horatioPistachio/WashingLineMonitor-P0001/Exports/WashingLineMonitor-P0001_AC/WashingLineMonitor-P0001_AC_BOM.csv

Reference | Qty | Value | Footprint | Supplier | Supplier Part Number | DNP
BT3 | 1 | Battery_Cell | Connector_JST:JST_SH_SM02B-SRSS-TB_1x02-1MP_P1.00mm_Horizontal | Core Electronics | 455-SM02B-SRSS-TBCT-ND
C1,C25 | 2 | 22uF | Capacitor_SMD:C_0805_2012Metric_Pad1.18x1.45mm_HandSolder | Digikey | 1276-CL21A226MAYNNNECT-ND
C2,C16,C17,C19,C23,C24 | 6 | 100nF | Capacitor_SMD:C_0805_2012Metric_Pad1.18x1.45mm_HandSolder | Digikey | 1276-1003-1-ND
C3,C4 | 2 | 4.7uF | Capacitor_SMD:C_0805_2012Metric_Pad1.18x1.45mm_HandSolder | Digikey | 1276-1244-1-ND
C5,C14,C15 | 3 | 10uF | Capacitor_SMD:C_0805_2012Metric_Pad1.18x1.45mm_HandSolder | Digikey | 1276-1096-1-ND
C6,C7 | 2 | 1nF | Capacitor_SMD:C_0805_2012Metric_Pad1.18x1.45mm_HandSolder | Digikey | 1276-2425-1-ND
C8,C11,C22 | 3 | 10nF | Capacitor_SMD:C_0805_2012Metric_Pad1.18x1.45mm_HandSolder | Digikey | 1276-1015-1-ND
C9,C12 | 2 | 470nF | Capacitor_SMD:C_0805_2012Metric_Pad1.18x1.45mm_HandSolder | Digikey | 1276-6480-1-ND
C10,C13 | 2 | 22nF | Capacitor_SMD:C_0805_2012Metric_Pad1.18x1.45mm_HandSolder | Digikey | 1276-2488-1-ND
C18,C20,C21 | 3 | 1uF | Capacitor_SMD:C_0805_2012Metric_Pad1.18x1.45mm_HandSolder | Digikey | 1276-1029-1-ND
D2 | 1 | BZX84C5V1-TP | Package_TO_SOT_SMD:SOT-23 | Digikey | BZX84C5V1-TPMSCT-ND
D3 | 1 | LED | LED_SMD:LED_0805_2012Metric_Pad1.15x1.40mm_HandSolder |  | 160-1426-1-ND
J1,J2 | 2 | S1711-46R | Hydro_footprints:HARWIN_S1711-46R |  | 952-1475-1-ND
J3 | 1 | Conn_02x03_Odd_Even | Connector_PinHeader_1.27mm:PinHeader_2x03_P1.27mm_Vertical_SMD | Digikey | SAM13920TR-ND
L1 | 1 | WR483245-15F5-G | Connector_JST:JST_SH_SM02B-SRSS-TB_1x02-1MP_P1.00mm_Horizontal | Digikey | 455-SM02B-SRSS-TBCT-ND
Q1 | 1 | PJA3401A_R1_00001 | Package_TO_SOT_SMD:SOT-23 |  | 3757-PJA3401A_R1_00001CT-ND
Q3 | 1 | Q_Dual_NMOS_PMOS_G1S2G2D2S1D1 | Package_SO:TSOP-6_1.65x3.05mm_P0.95mm |  | 785-1787-1-ND
R1,R10,R11,R16,R20 | 5 | 500k | Resistor_SMD:R_0805_2012Metric_Pad1.20x1.40mm_HandSolder | Digikey | 738-RNCF0805BTE500KCT-ND
R2,R5,R13,R14,R15,R17,R18,R19 | 8 | 10k | Resistor_SMD:R_0805_2012Metric_Pad1.20x1.40mm_HandSolder | Digikey | P10KACT-ND
R6 | 1 | 100 | Resistor_SMD:R_0805_2012Metric_Pad1.20x1.40mm_HandSolder | Digikey | P100ACT-ND
R7 | 1 | 430 | Resistor_SMD:R_0805_2012Metric_Pad1.20x1.40mm_HandSolder | Digikey | P430DACT-ND
R8,R12 | 2 | 2.4k | Resistor_SMD:R_0805_2012Metric_Pad1.20x1.40mm_HandSolder | Digikey | P2.4KDACT-ND
R9 | 1 | 20k | Resistor_SMD:R_0805_2012Metric_Pad1.20x1.40mm_HandSolder | Digikey | P20KACT-ND
SW1 | 1 | A6TN-1104 | Button_Switch_THT:SW_DIP_SPSTx01_Slide_6.7x4.1mm_W7.62mm_P2.54mm_LowProfile |  | Z5195-ND
TH1 | 1 | Thermistor_NTC | Resistor_SMD:R_0402_1005Metric_Pad0.72x0.64mm_HandSolder |  | 445-2550-1-ND
U1 | 1 | HDC2080 | Sensor_Humidity:Texas_S-PWSON-N6-HDC2080 |  | 296-52638-1-ND
U2 | 1 | TLV2371DBV | Package_TO_SOT_SMD:SOT-23-5 | Digikey | 296-13057-1-ND
U3 | 1 | ESP32-C6-MINI-1 | RF_Module:ESP32-C6-MINI-1 |  | 1965-ESP32-C6-MINI-1-N4TR-ND
U5 | 1 | TLV75533PDBV | Package_TO_SOT_SMD:SOT-23-5 |  | 296-50411-1-ND
U6 | 1 | BQ51050BRHL | Package_DFN_QFN:Texas_VQFN-RHL-20 | Digikey | 296-BQ51050BRHLRCT-ND
