horatioPistachio/WashingLineMonitor-P0001/Exports/AA/WashingLineMonitor-P0001.step

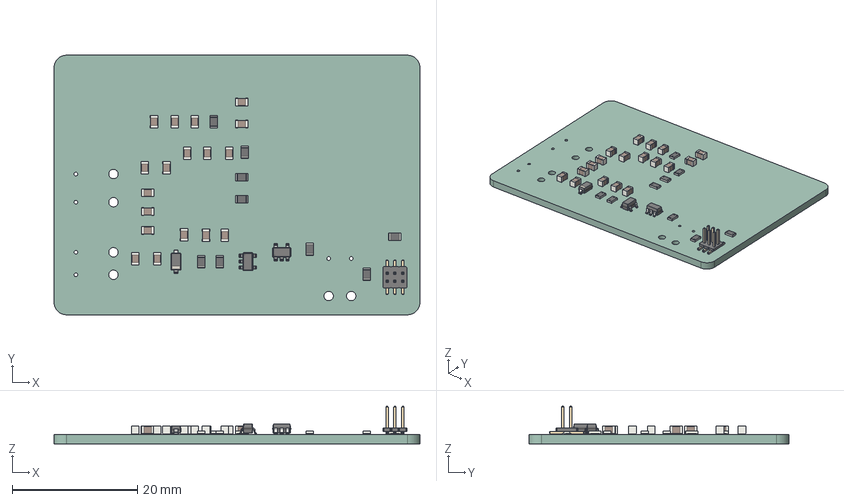
[picture p1: CAD file, 2025-09-13]
Exports/AA/WashingLineMonitor-P0001.step
58.5 x 41.5 x 6.00 mm
R_0805_2012Metric x 9
C_0805_2012Metric x 18
D_SOD-123
SOT-23-5 x 2
PinHeader_2x03_P1.27mm_Vertical_SMD
WashingLineMonitor-P0001_PCB
