horatioPistachio/WashingLineMonitor-P0001/Exports/WashingLineMonitor-P0001_AB/WashingLineMonitor-P0001_AB.step

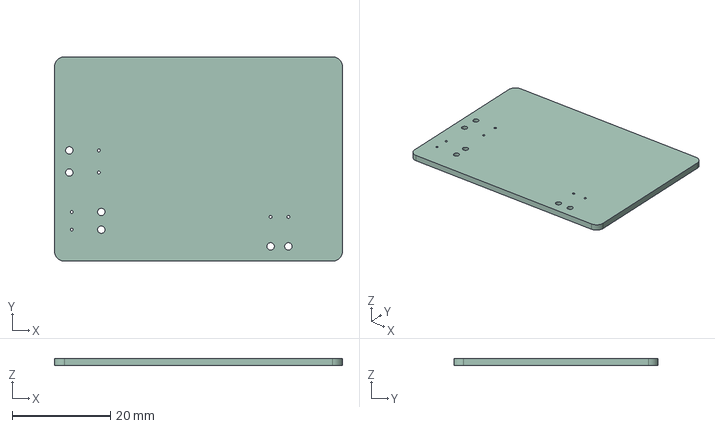
[picture p2: CAD file, 2025-09-14]
Exports/WashingLineMonitor-P0001_AB/WashingLineMonitor-P0001_AB.step
58.5 x 41.5 x 1.51 mm
