horatioPistachio/WashingLineMonitor-P0001/Exports/WashingLineMonitor-P0001_AD/WashingLineMonitor-P0001_AD.step

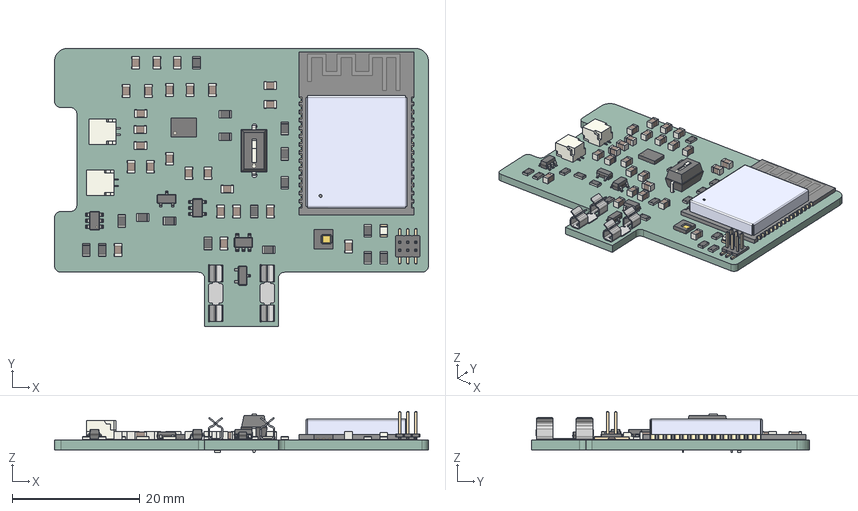
[picture p4: CAD file, 2026-07-25]
Exports/WashingLineMonitor-P0001_AD/WashingLineMonitor-P0001_AD.step
58.5 x 43.5 x 6.43 mm
R_0805_2012Metric x 17
C_0805_2012Metric x 25
SOT-23-6
QFN-20-1EP_3x4mm_Pitch0.5mm
SOT-23 x 2
ESP32-C6-WROOM-1-N8
JST_SH_SM02B-SRSS-TB_1x02-1MP_P1.00mm_Horizontal x 2
SOT-23-5 x 2
SW_DIP_SPSTx01_Slide_67x41mm_W762mm_P254mm_LowProfile
LED_0805_2012Metric
S1711-46R x 2
PinHeader_2x03_P127mm_Vertical_SMD
R_0402_1005Metric
WashingLineMonitor-P0001_PCB
