horatioPistachio/WashingLineMonitor-P0001/Exports/WashingLineMonitor-P0001_AC/WashingLineMonitor-P0001_AC_PCB.pdf

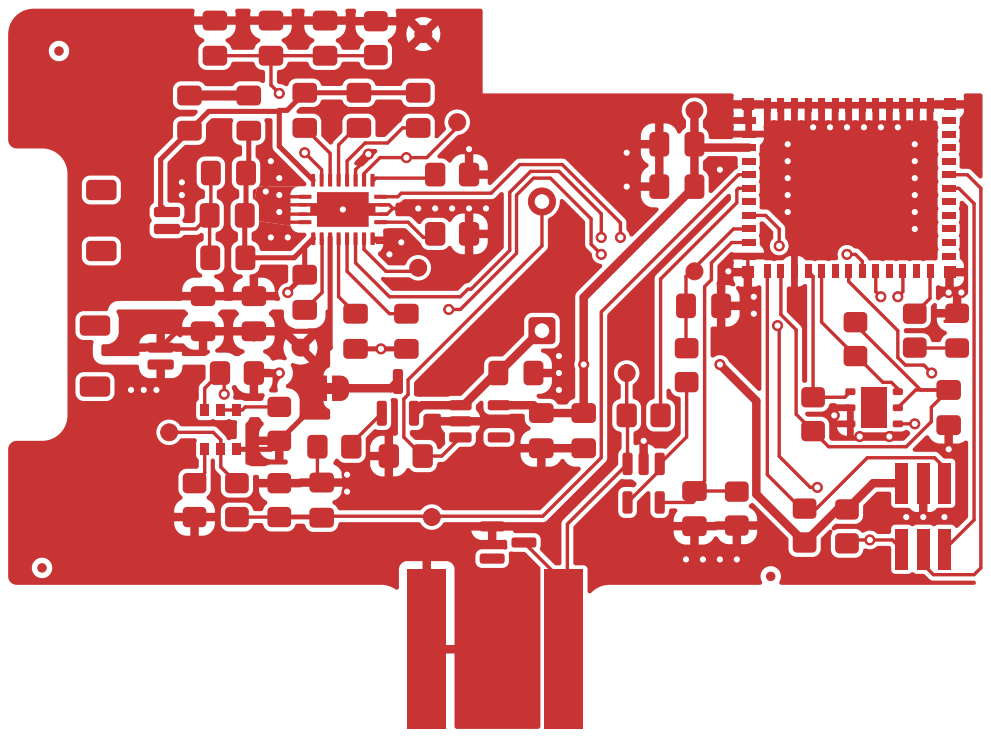
[picture p10: page 1]

AC - Added Connector, Switch to ESP32 C3, added humidity sensor and power switch
AB - Updated from AI review
AA - Original
Horatio Pistachio
Sheet:
File: WashingLineMonitor-P0001.kicad_pcb
Title: WashingLineMonitor-P0001

Size: A4 | Rev: AC
KiCad E.D.A. 10.0.3 | Id: 1/7

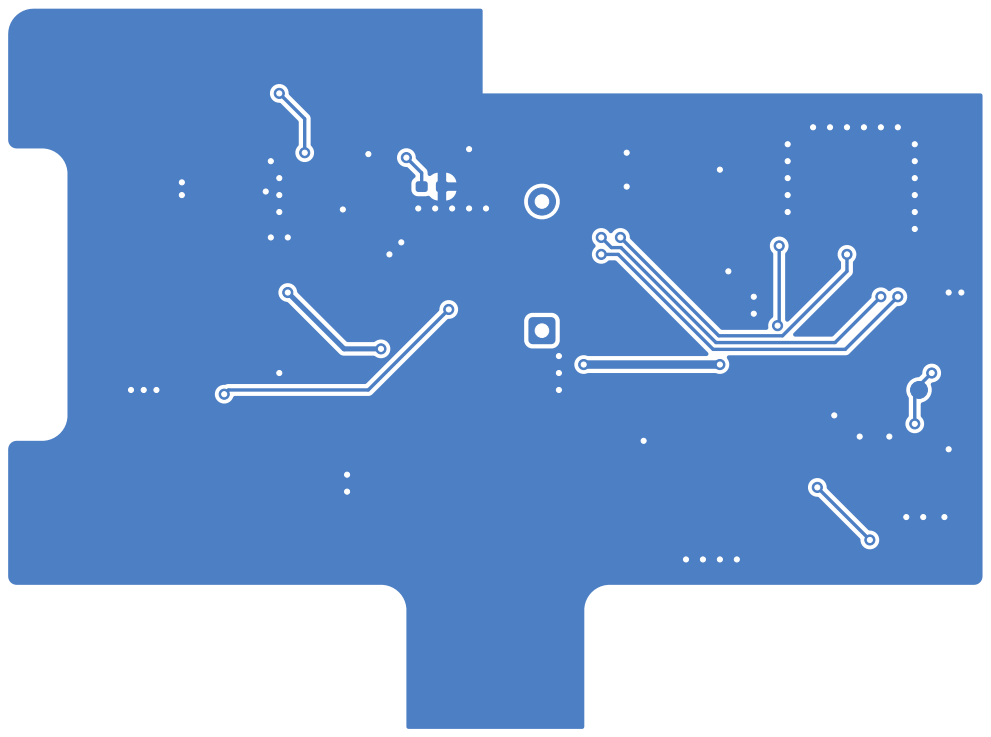
[picture p11: page 2]
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

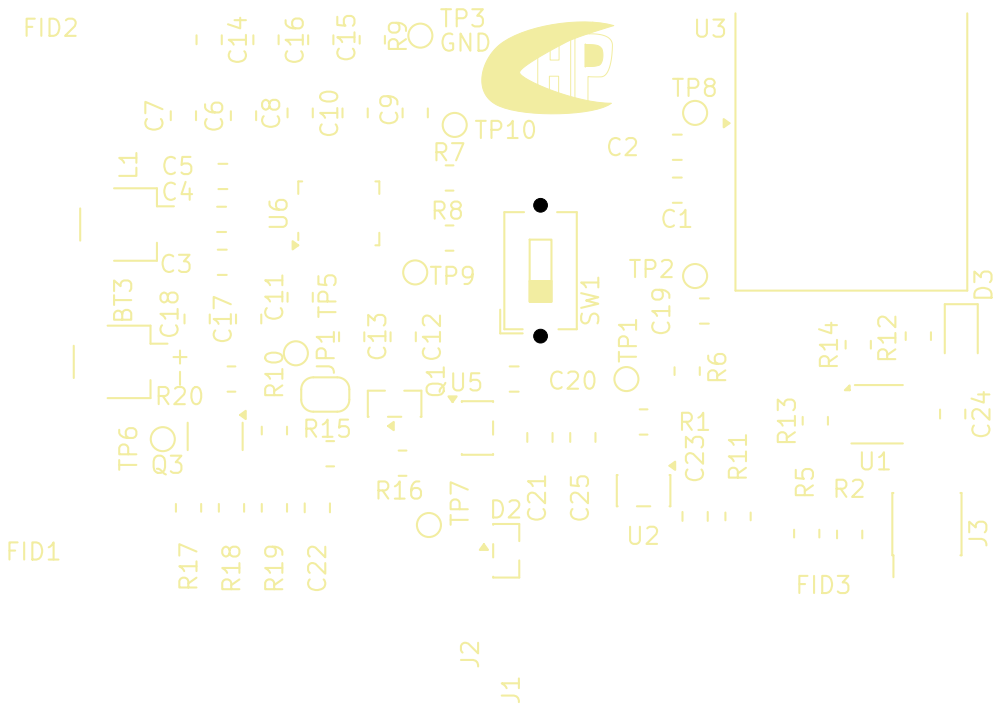
[picture p12: page 3]
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

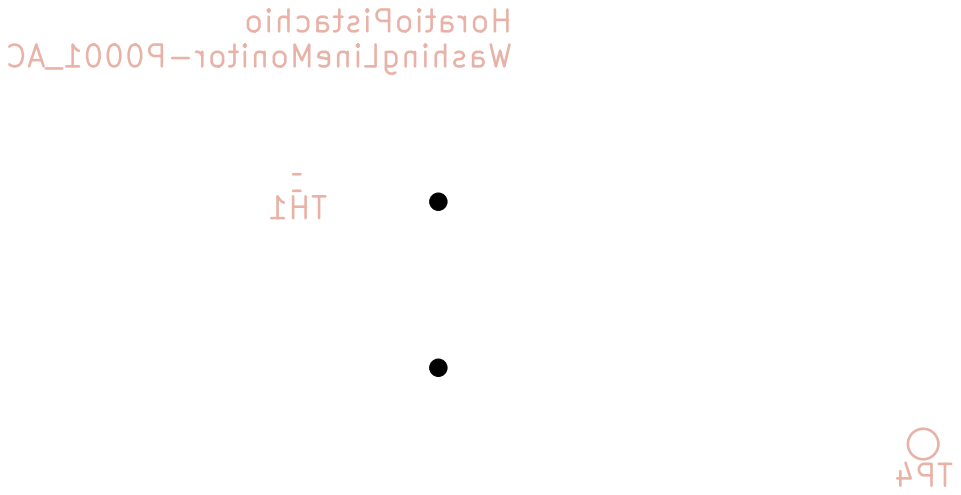
[picture p13: page 4]
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

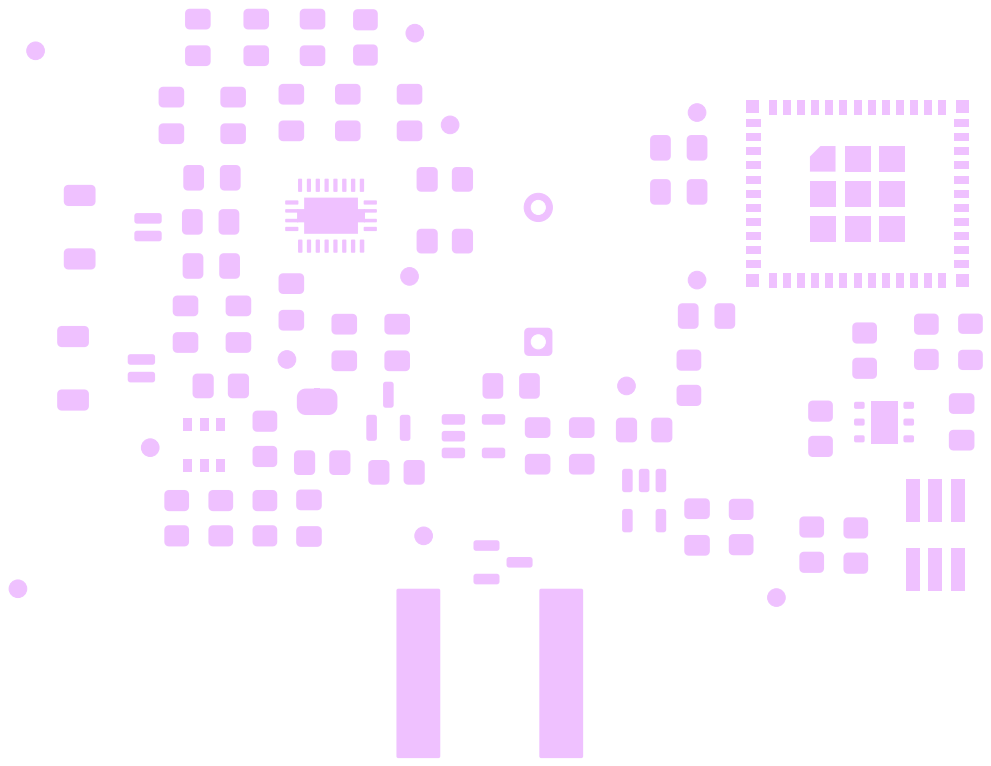
[picture p14: page 5]
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

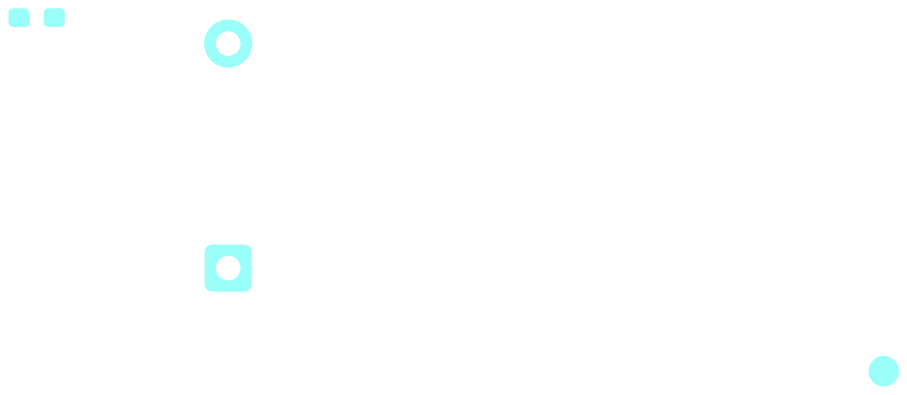
[picture p15: page 6]
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

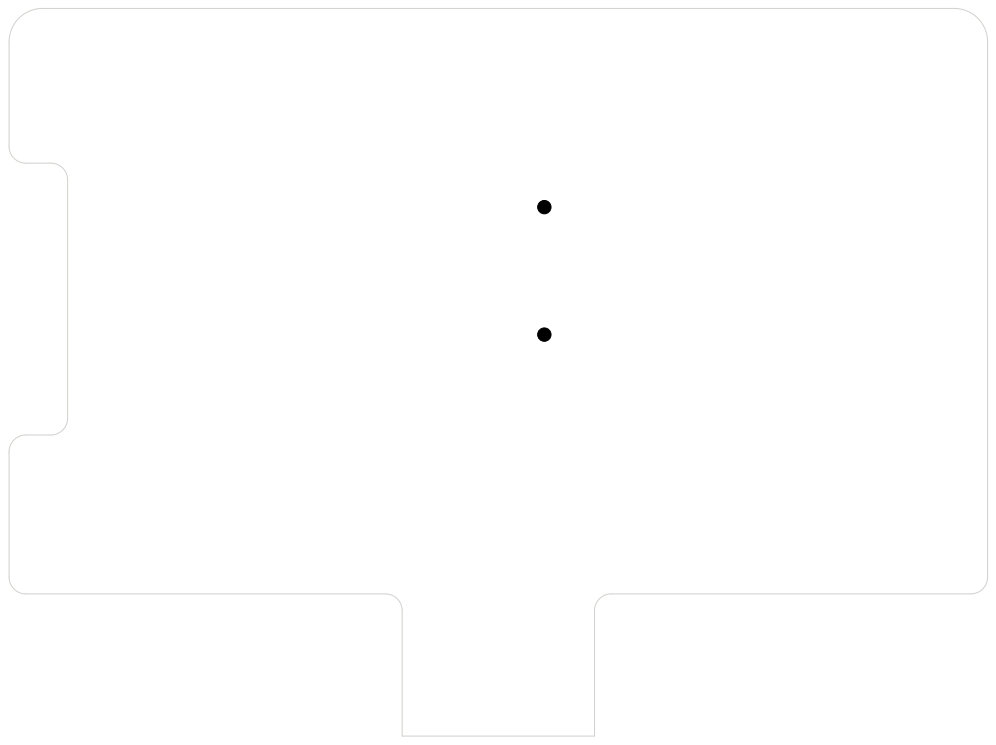
[picture p16: page 7]
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
