horatioPistachio/WashingLineMonitor-P0001/Exports/WashingLineMonitor-P0001_AD/WashingLineMonitor-P0001_AD.pdf

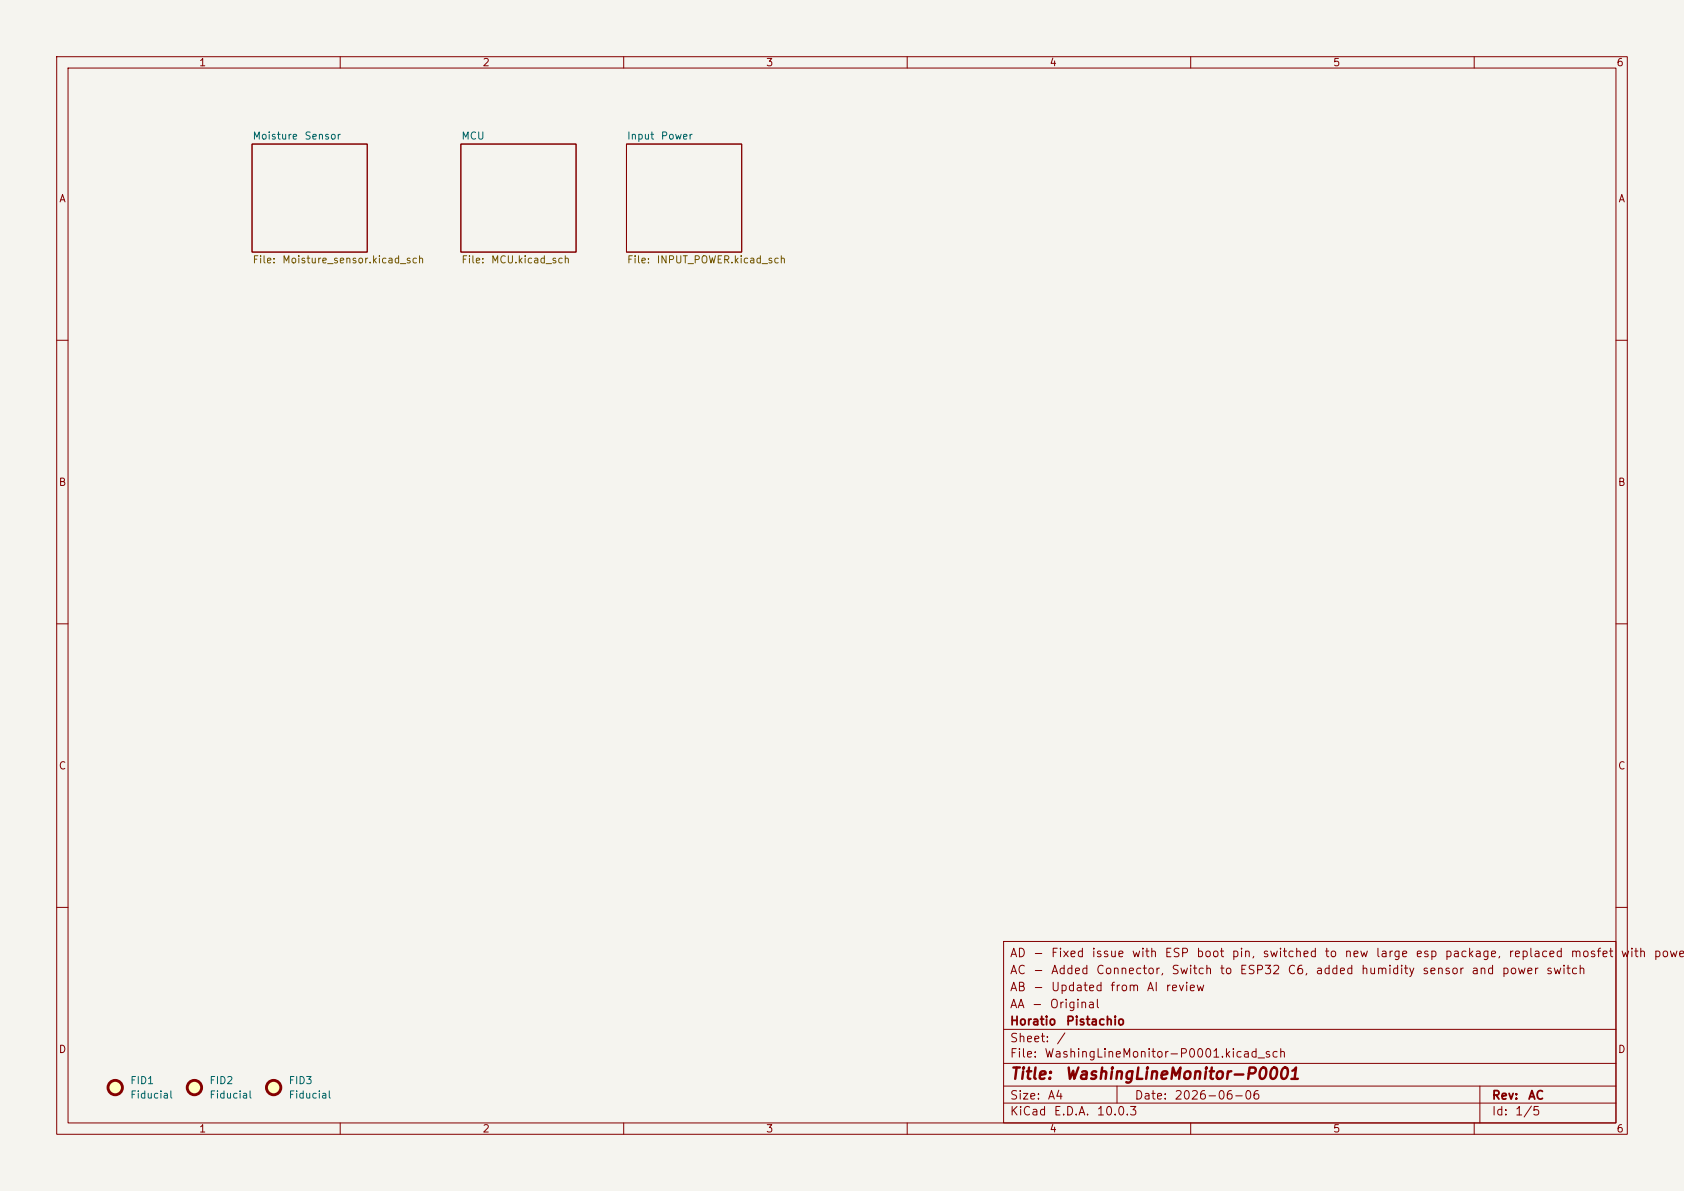
[picture p17: page 1]

AC - Added Connector, Switch to ESP32 C6, added humidity sensor and power switch
AB - Updated from AI review
AA - Original
Horatio Pistachio
Sheet: /
File: WashingLineMonitor-P0001.kicad_sch
Title: WashingLineMonitor-P0001

Size: A4 | Rev: AC
KiCad E.D.A. 10.0.3 | Id: 1/5


The sensors appearto havea resistance between 30k ohms wet and 2M ohms when dry. The 500k resistor give the best voltage vs cloth

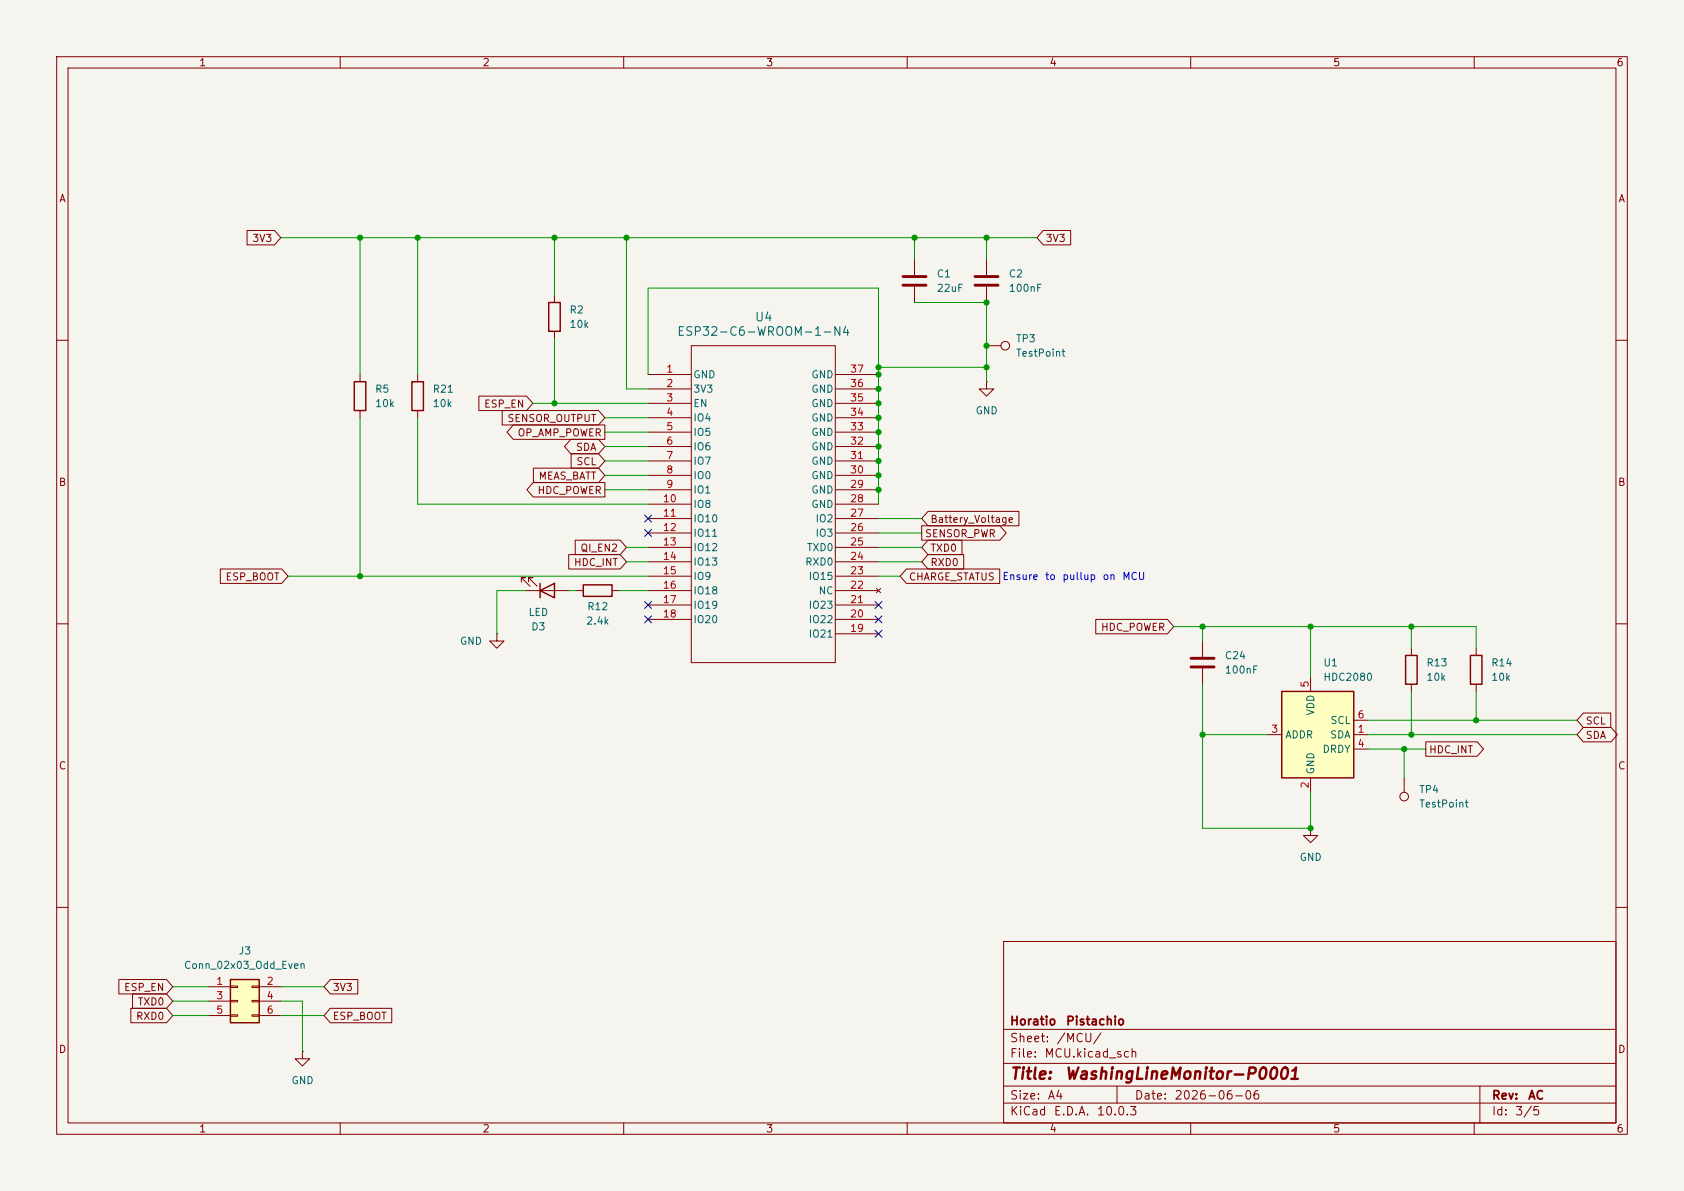
[picture p18: page 3]

Ensure to pullup on MCU

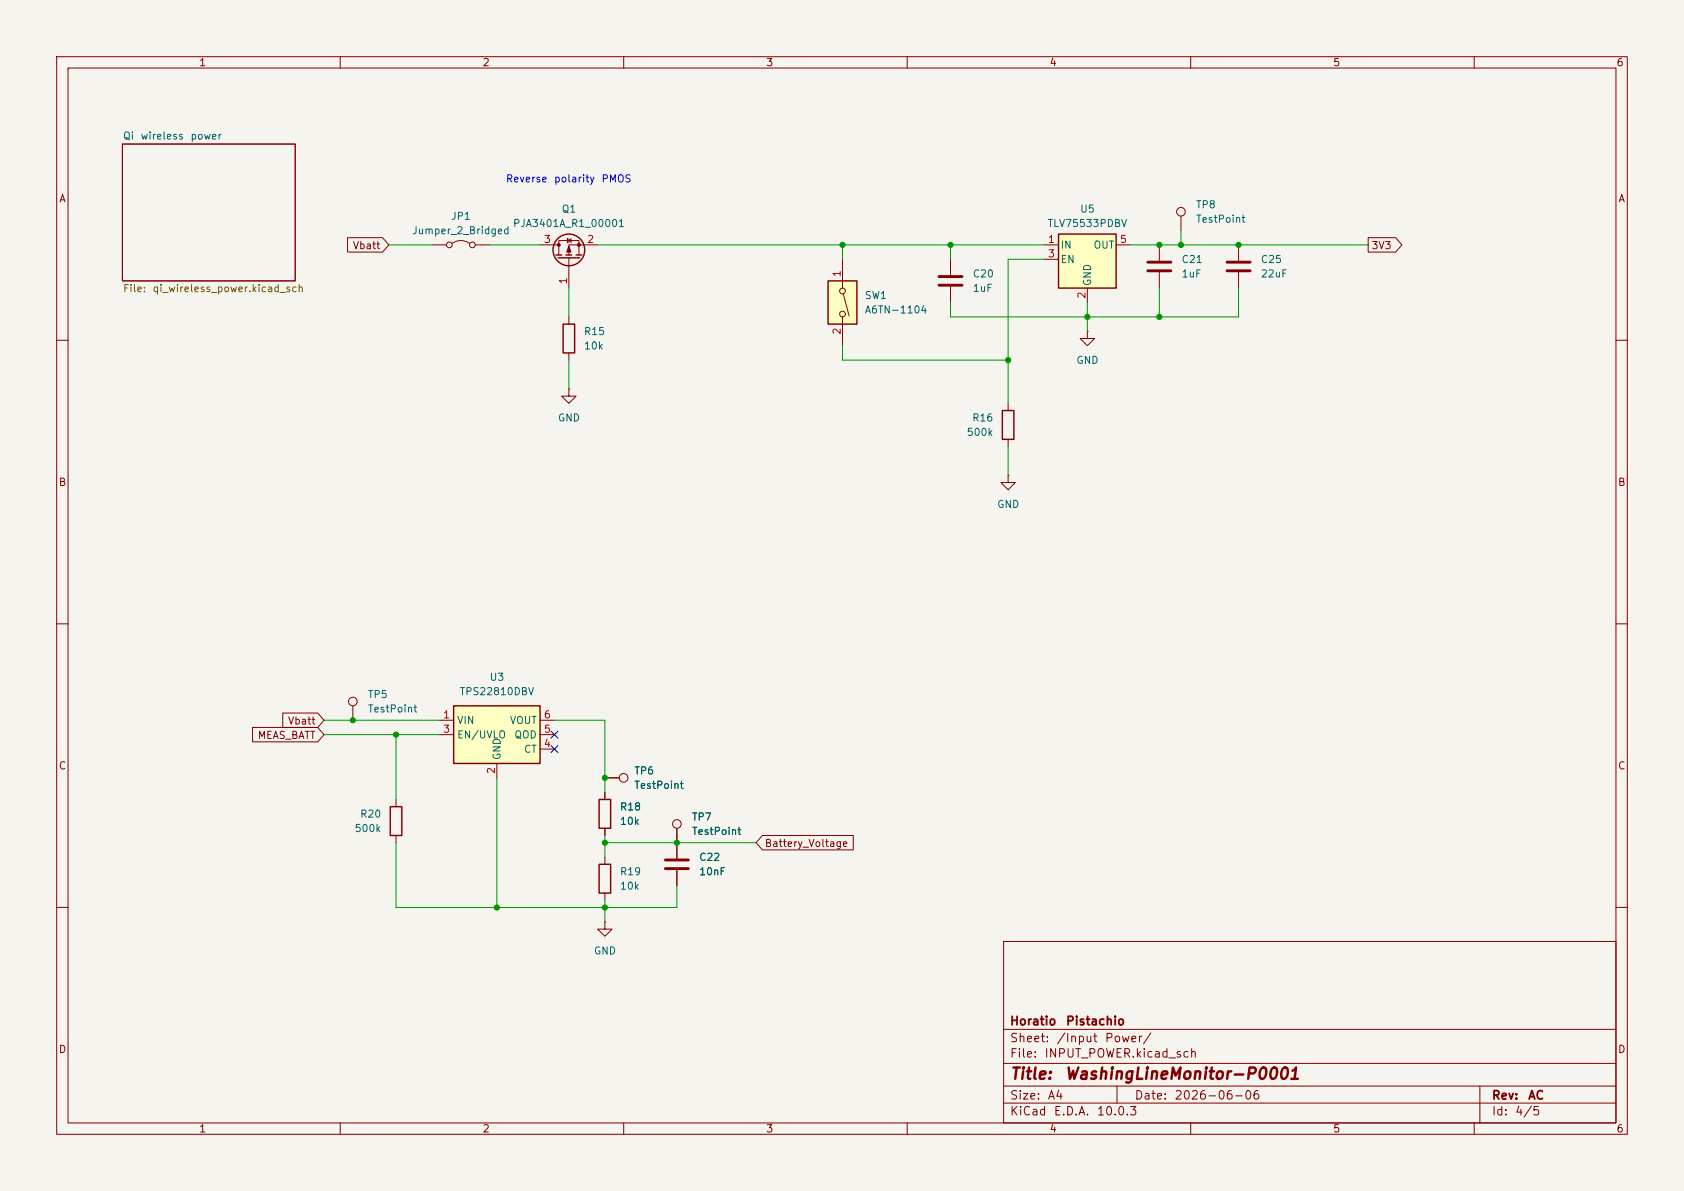
[picture p19: page 4]


From BQ51050BRHL datasheet application example
Assuming L's (inductance in setup) and Ls (free space
inductance) are the same at 100khz

Vbatt NTC_BATT CHARGE_STATUS Battery charging Kilm = 314 Aohm(BQ51050)

Ibulk = 500mA (0.5c of a 1000mAh battery) %Ibulk = 10 (cut off once we are charging at 10% of max) Rfod = 200ohm (BQ51050) Kterm = 240 Ohm/%

Rfod is tuneable and reccomended to start at 20k and change if needed

Horatio Pistachio
Sheet: /Input Power/Qi wireless power/
File: qi_wireless_power.kicad_sch
Title: WashingLineMonitor-P0001
