horatioPistachio/WashingLineMonitor-P0001/Exports/WashingLineMonitor-P0001_AB/WashingLineMonitor-P0001_AB.pdf

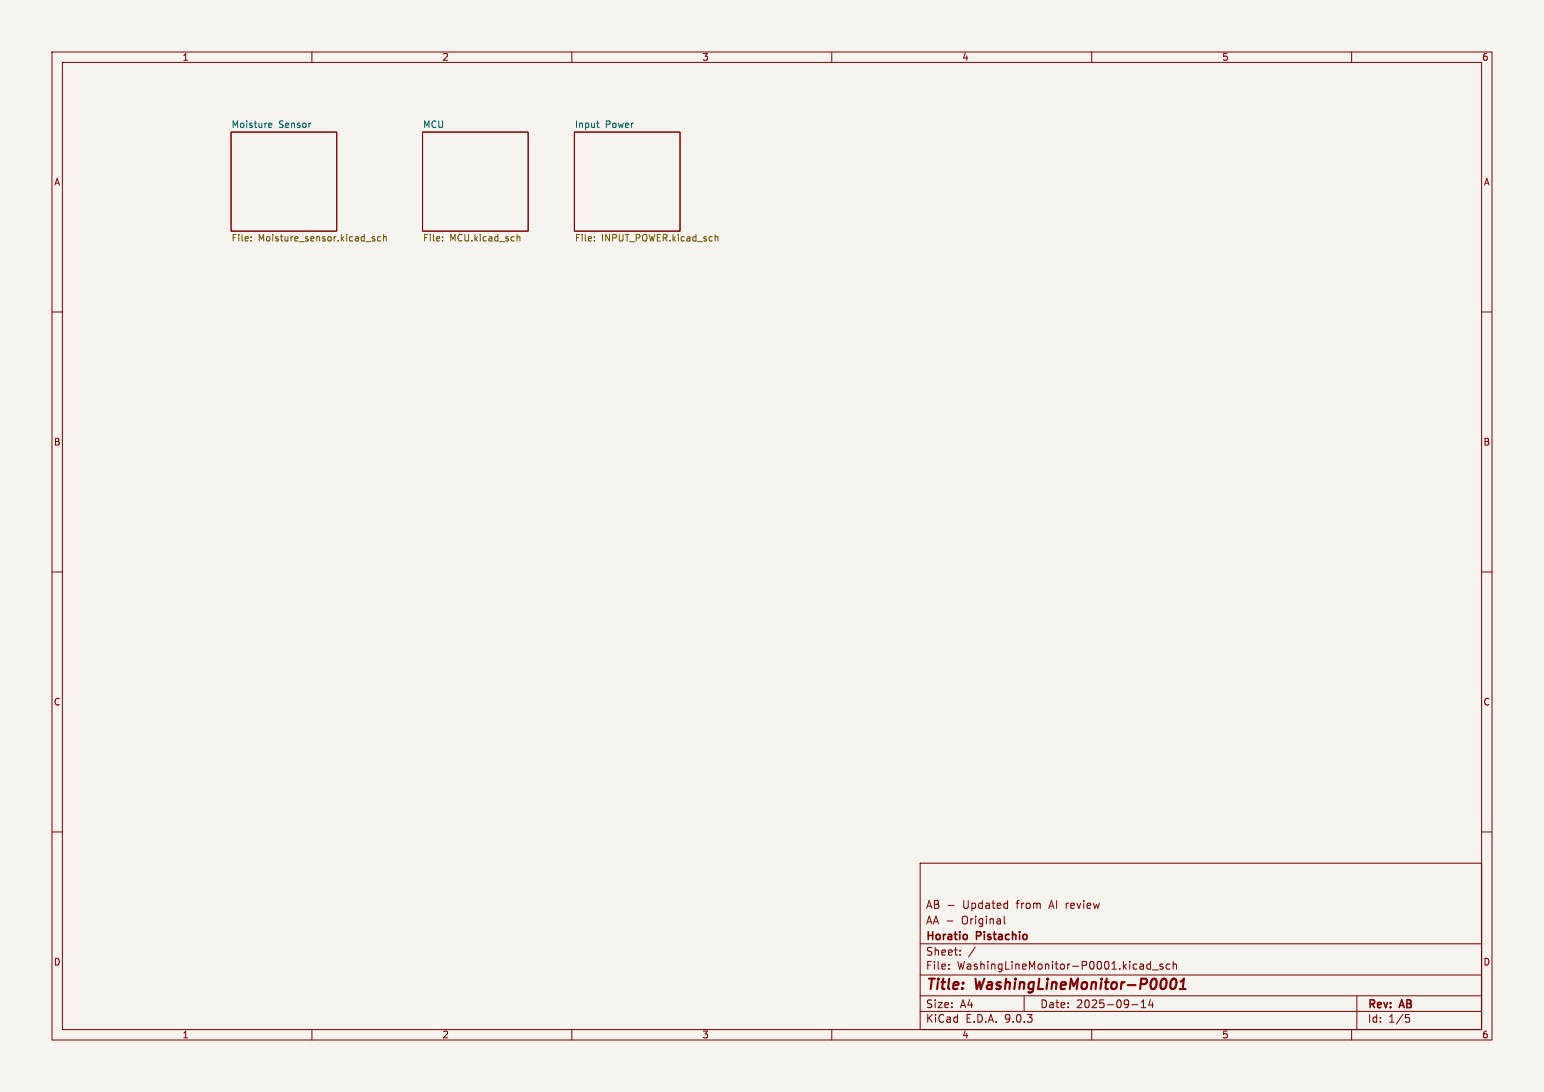
[picture p27: page 1]

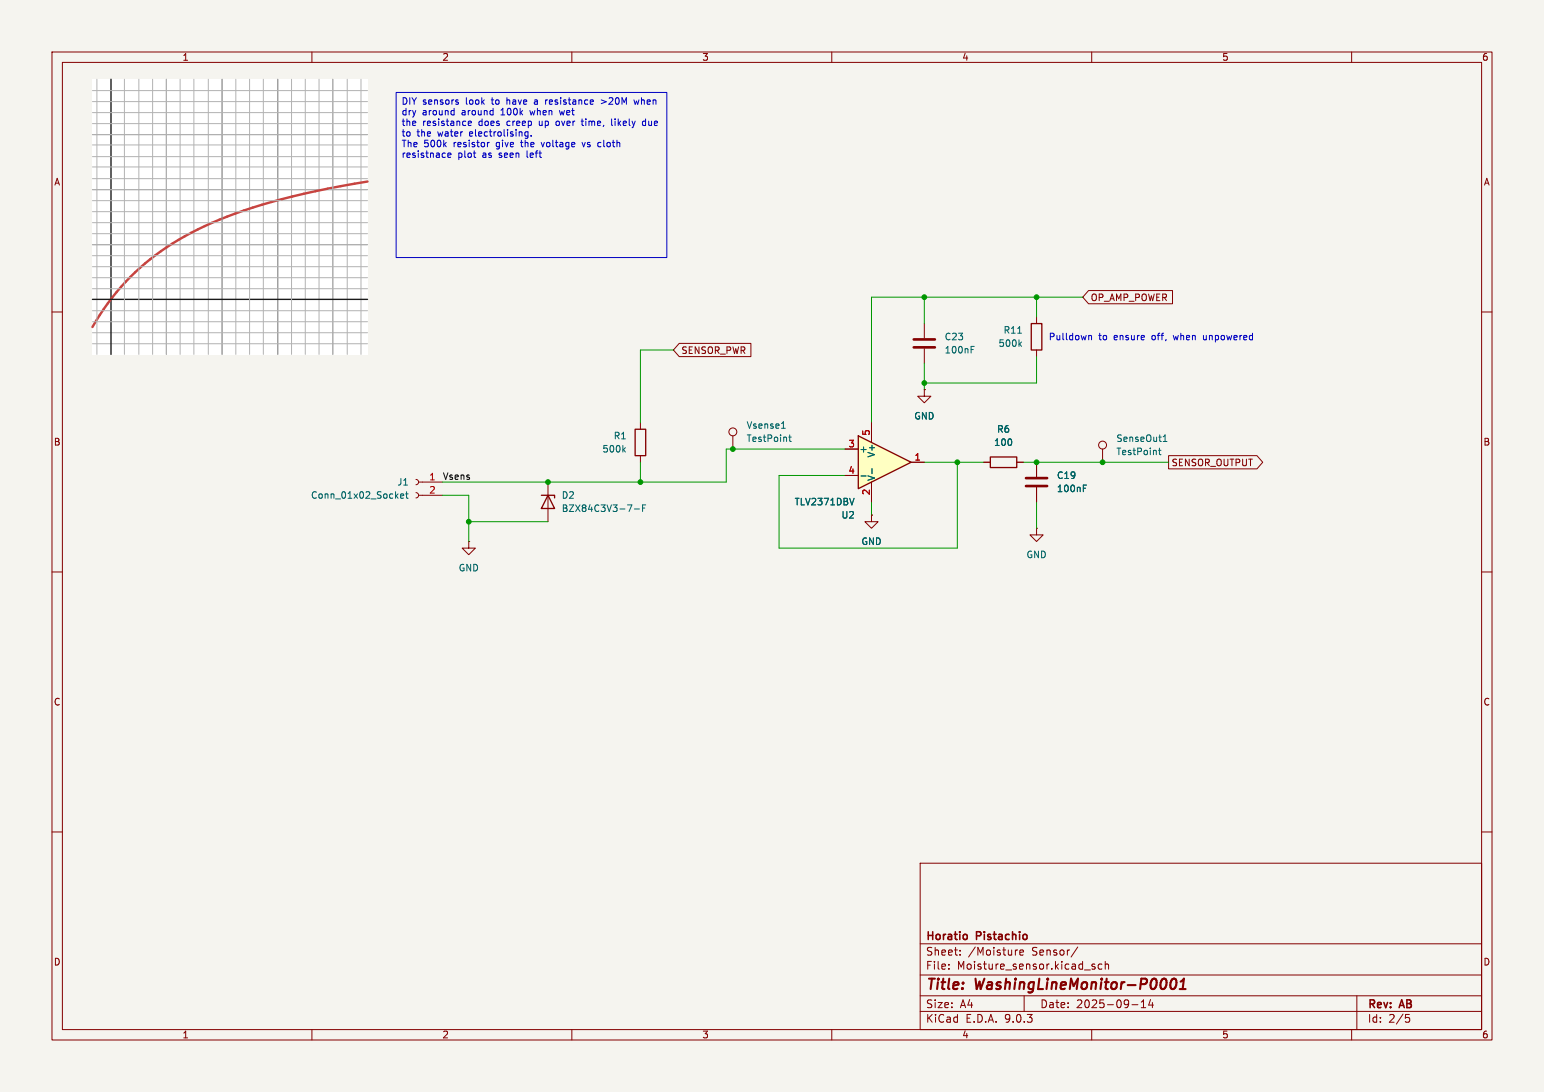
[picture p28: page 2]

dry around around 100k when wet

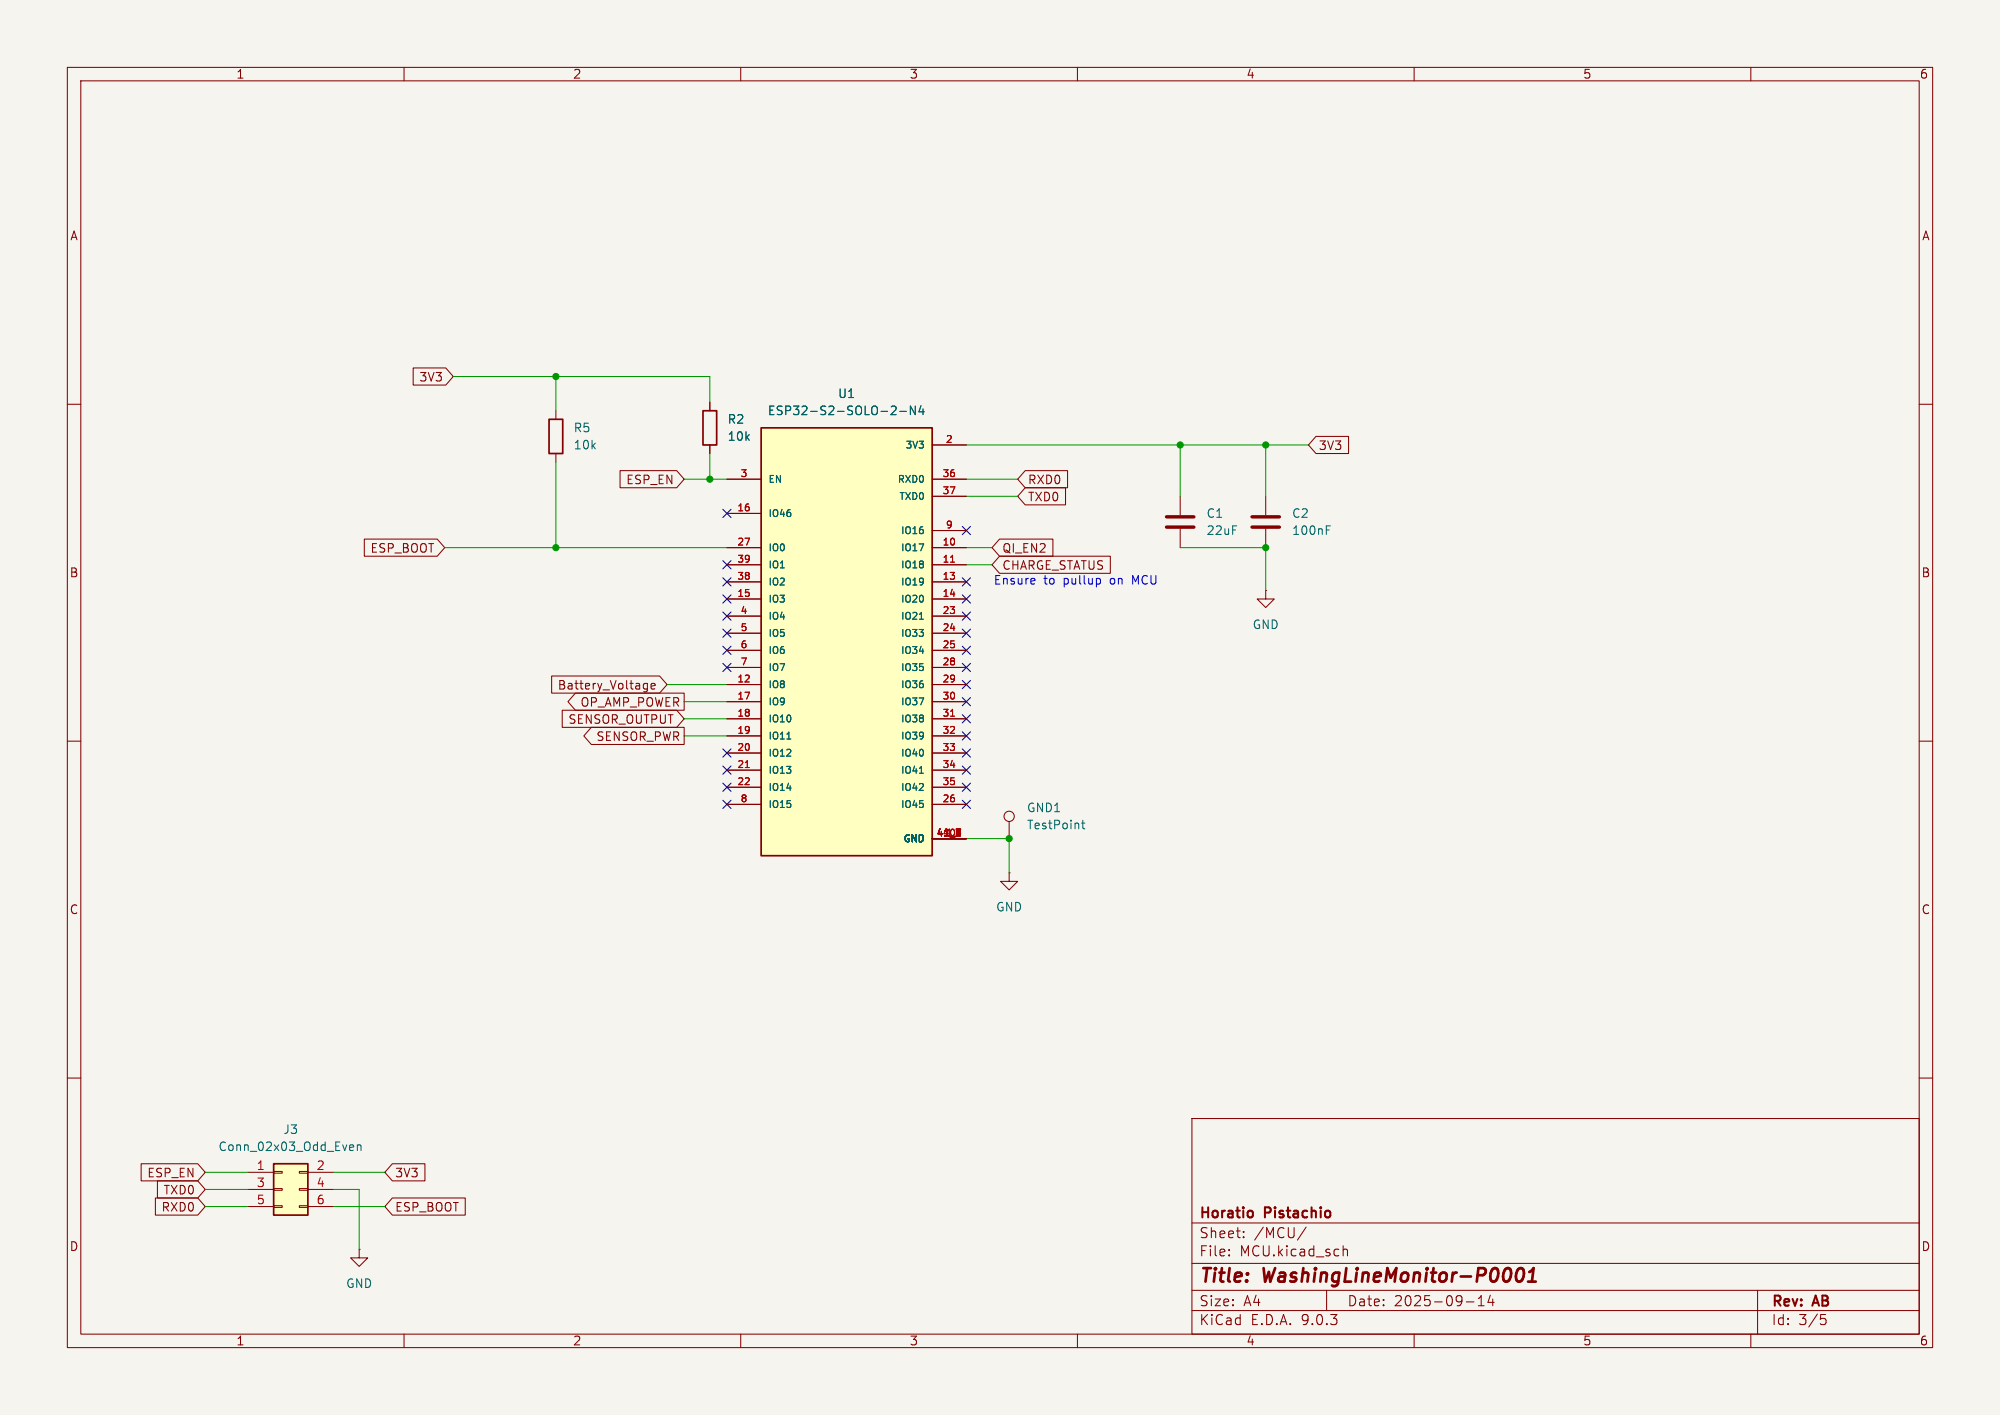
[picture p29: page 3]

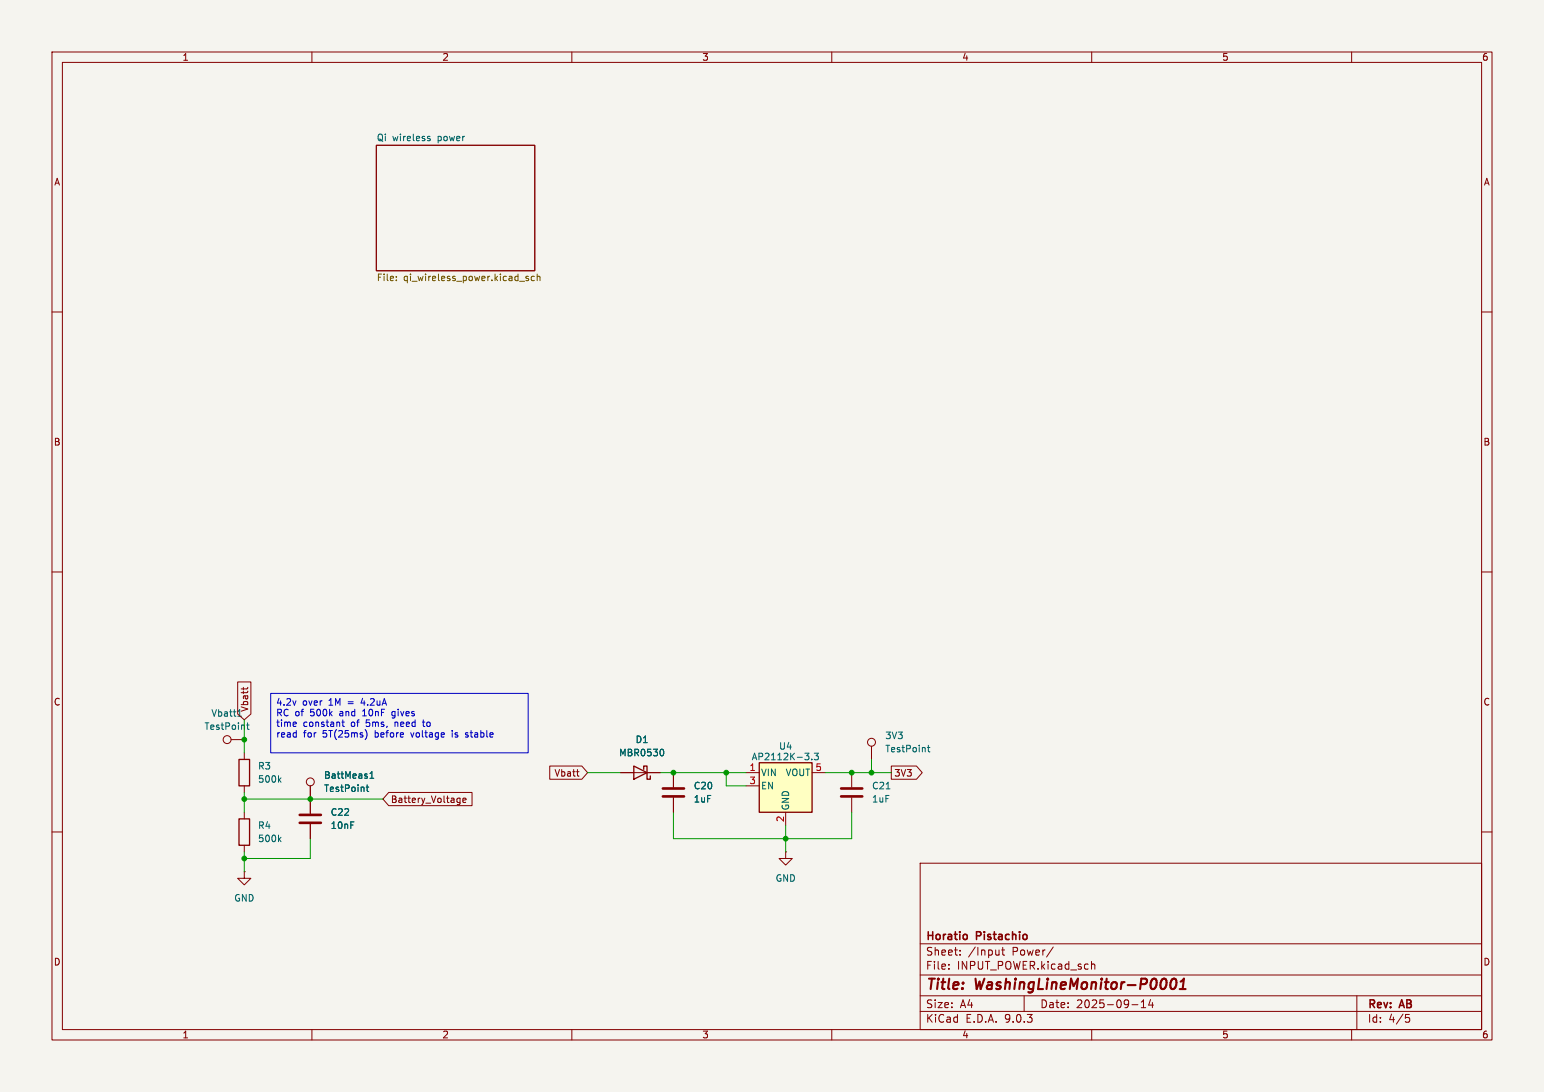
[picture p30: page 4]

Qi wireless power File: qi_wireless_power.kicad_sch R3

4.2v over 1M = 4.2uA RC of 500k and 10nF gives

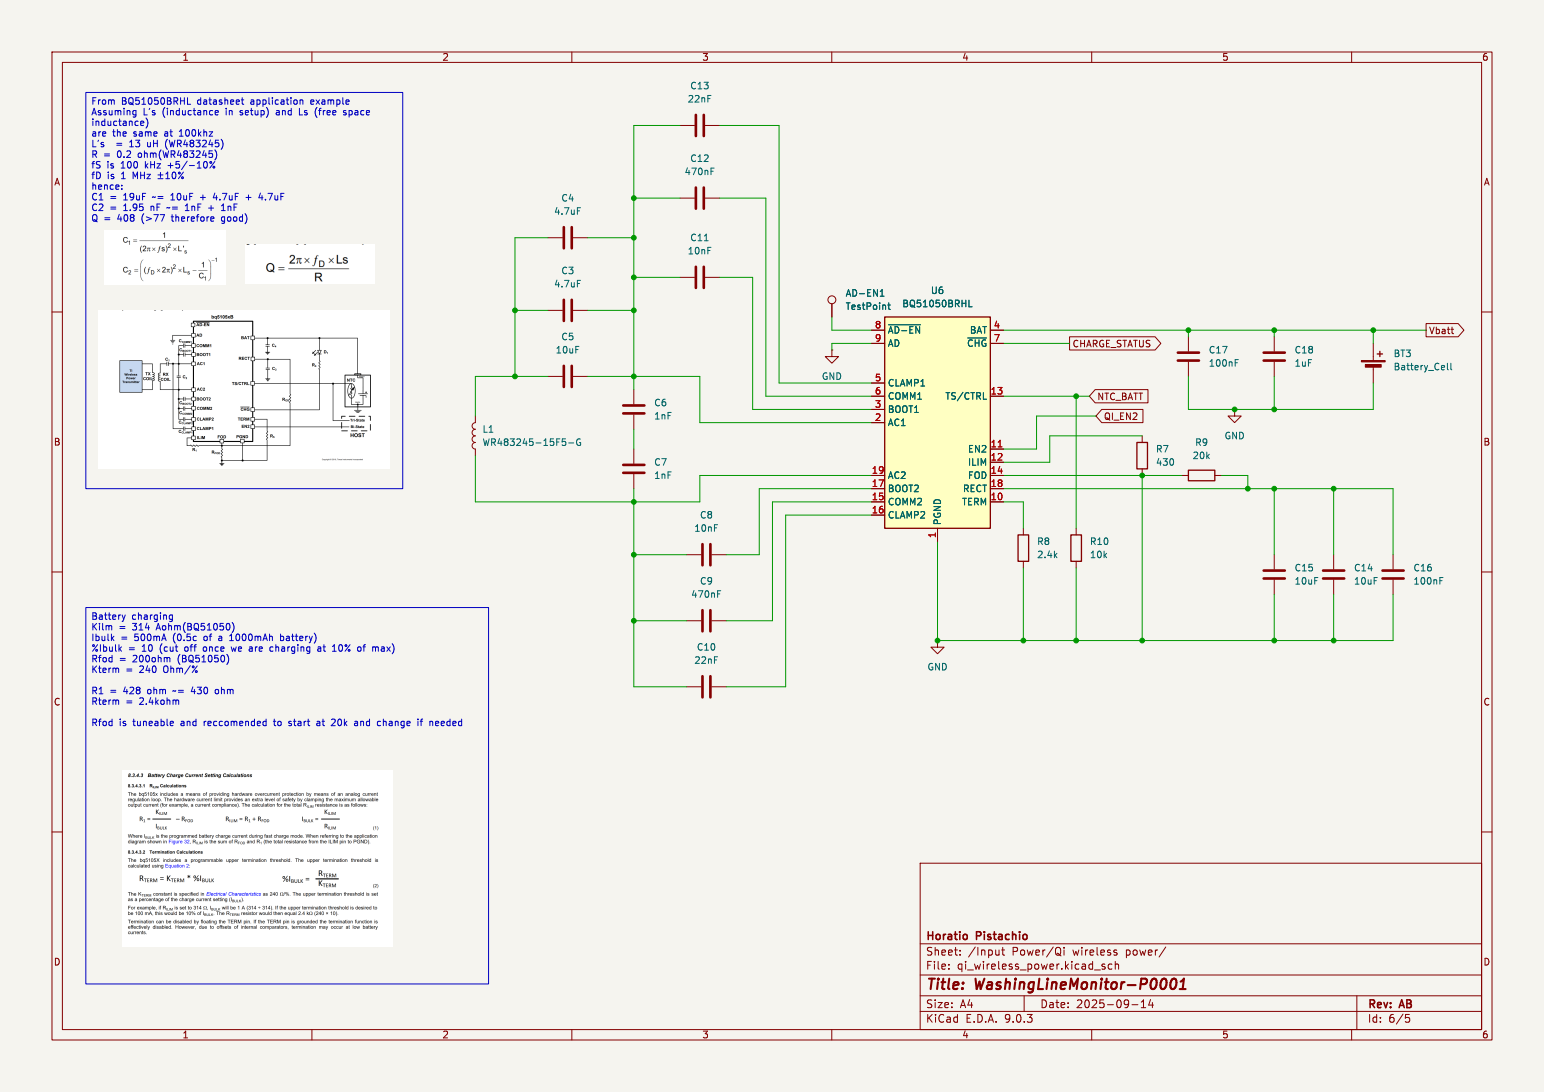
[picture p31: page 5]

fS is 100 kHz +5/-10%
fD is 1 MHz þÿ±10%

1 BAT 4 ~{CHG}7 TS/CTRL 13 EN2 11

Battery charging Kilm = 314 Aohm(BQ51050)
