horatioPistachio/WashingLineMonitor-P0001/WashingLineMonitor-P0001.kicad_pcb

## KiCad design WashingLineMonitor-P0001.kicad_pcb (2026-07-25)

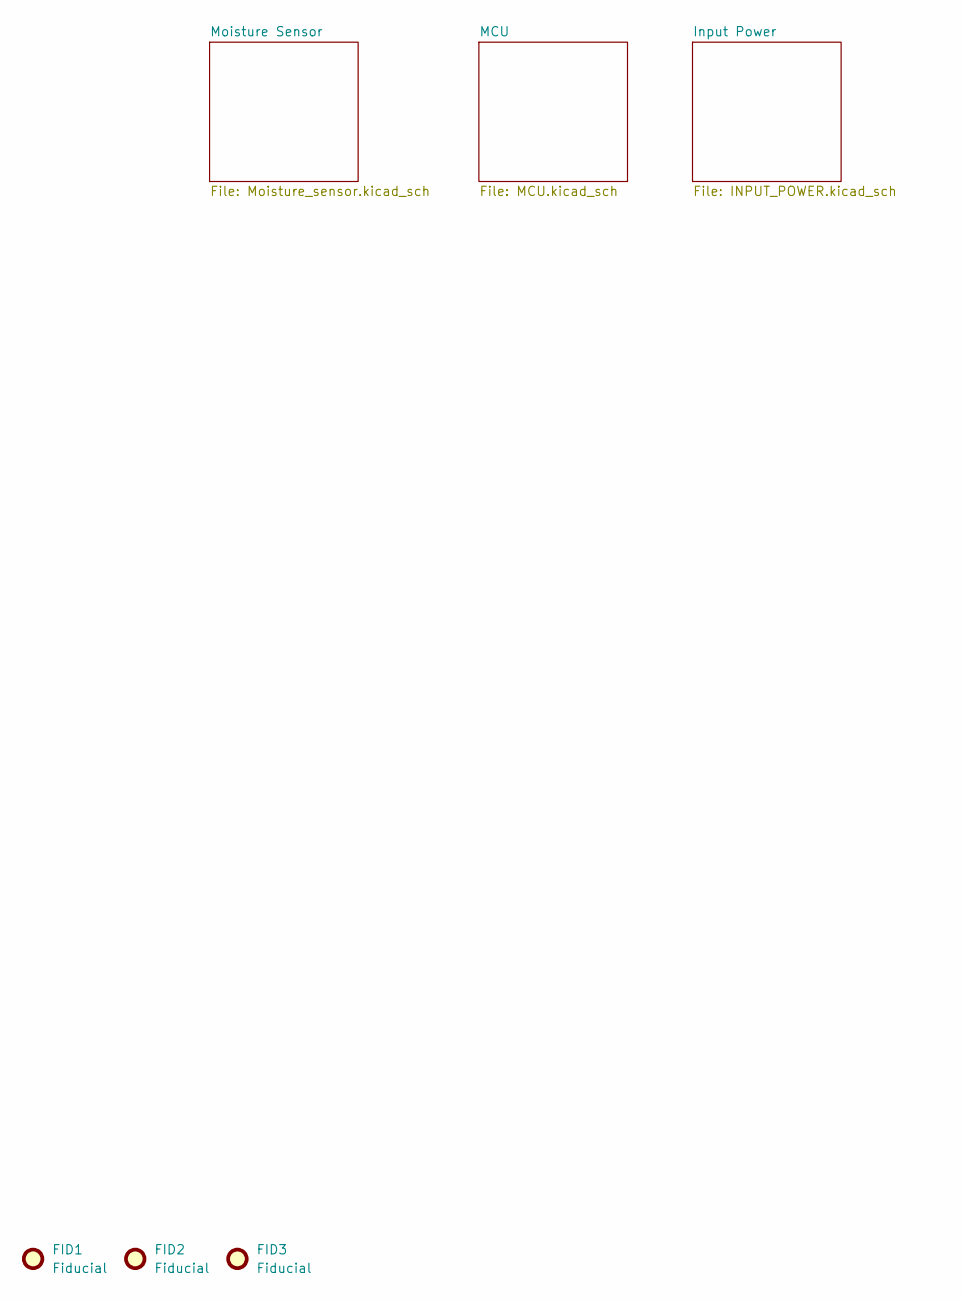
[picture p39: schematic WashingLineMonitor-P0001.kicad_sch]

Parts:
FID1, FID2, FID3: Fiducial; Fiducial_0.5mm_Mask1mm

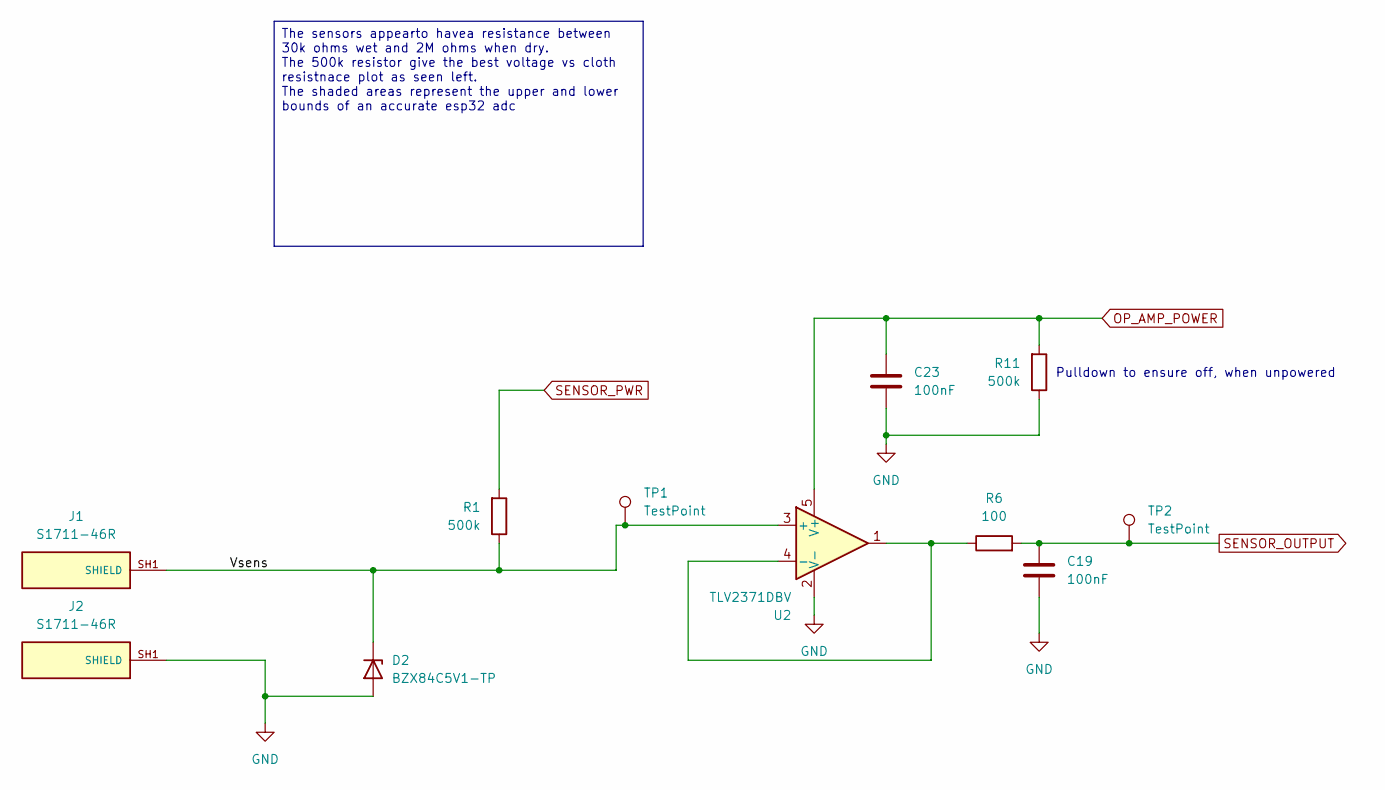
[picture p40: schematic Moisture_sensor.kicad_sch, WashingLineMonitor-P0001]

Parts:
C19, C23: 100nF; C_0805_2012Metric_Pad1.18x1.45mm_HandSolder
D2: BZX84C5V1-TP; SOT-23
J1, J2: S1711-46R; HARWIN_S1711-46R; PARTREV 8
R1, R11: 500k; R_0805_2012Metric_Pad1.20x1.40mm_HandSolder
R6: 100; R_0805_2012Metric_Pad1.20x1.40mm_HandSolder
TP1, TP2: TestPoint; TestPoint_Pad_D1.0mm
U2: TLV2371DBV; SOT-23-5

Connections:
/Moisture Sensor/Vsens: D2.3 (K), J1.SH1 (SHIELD_SH1), R1.1, TP1.1 (1_1), U2.3 (+)
GND: C19.2, C23.2, D2.1 (A), J2.SH1 (SHIELD_SH1), R11.1, U2.2 (V-); also elsewhere on the board
unnamed: R6.1, U2.1, U2.4 (-)
OP_AMP_POWER: C23.1, R11.2, U2.5 (V+); also elsewhere on the board
SENSOR_OUTPUT: C19.1, R6.2, TP2.1 (1_1); also elsewhere on the board
SENSOR_PWR: R1.2; also elsewhere on the board

Notes on the sheet:
Pulldown to ensure off, when unpowered
The sensors appearto havea resistance between 30k ohms wet and 2M ohms when dry. The 500k resistor give the best voltage vs cloth resistnace plot as seen left. The shaded areas represent the upper and lower bounds of an accurate esp32 adc

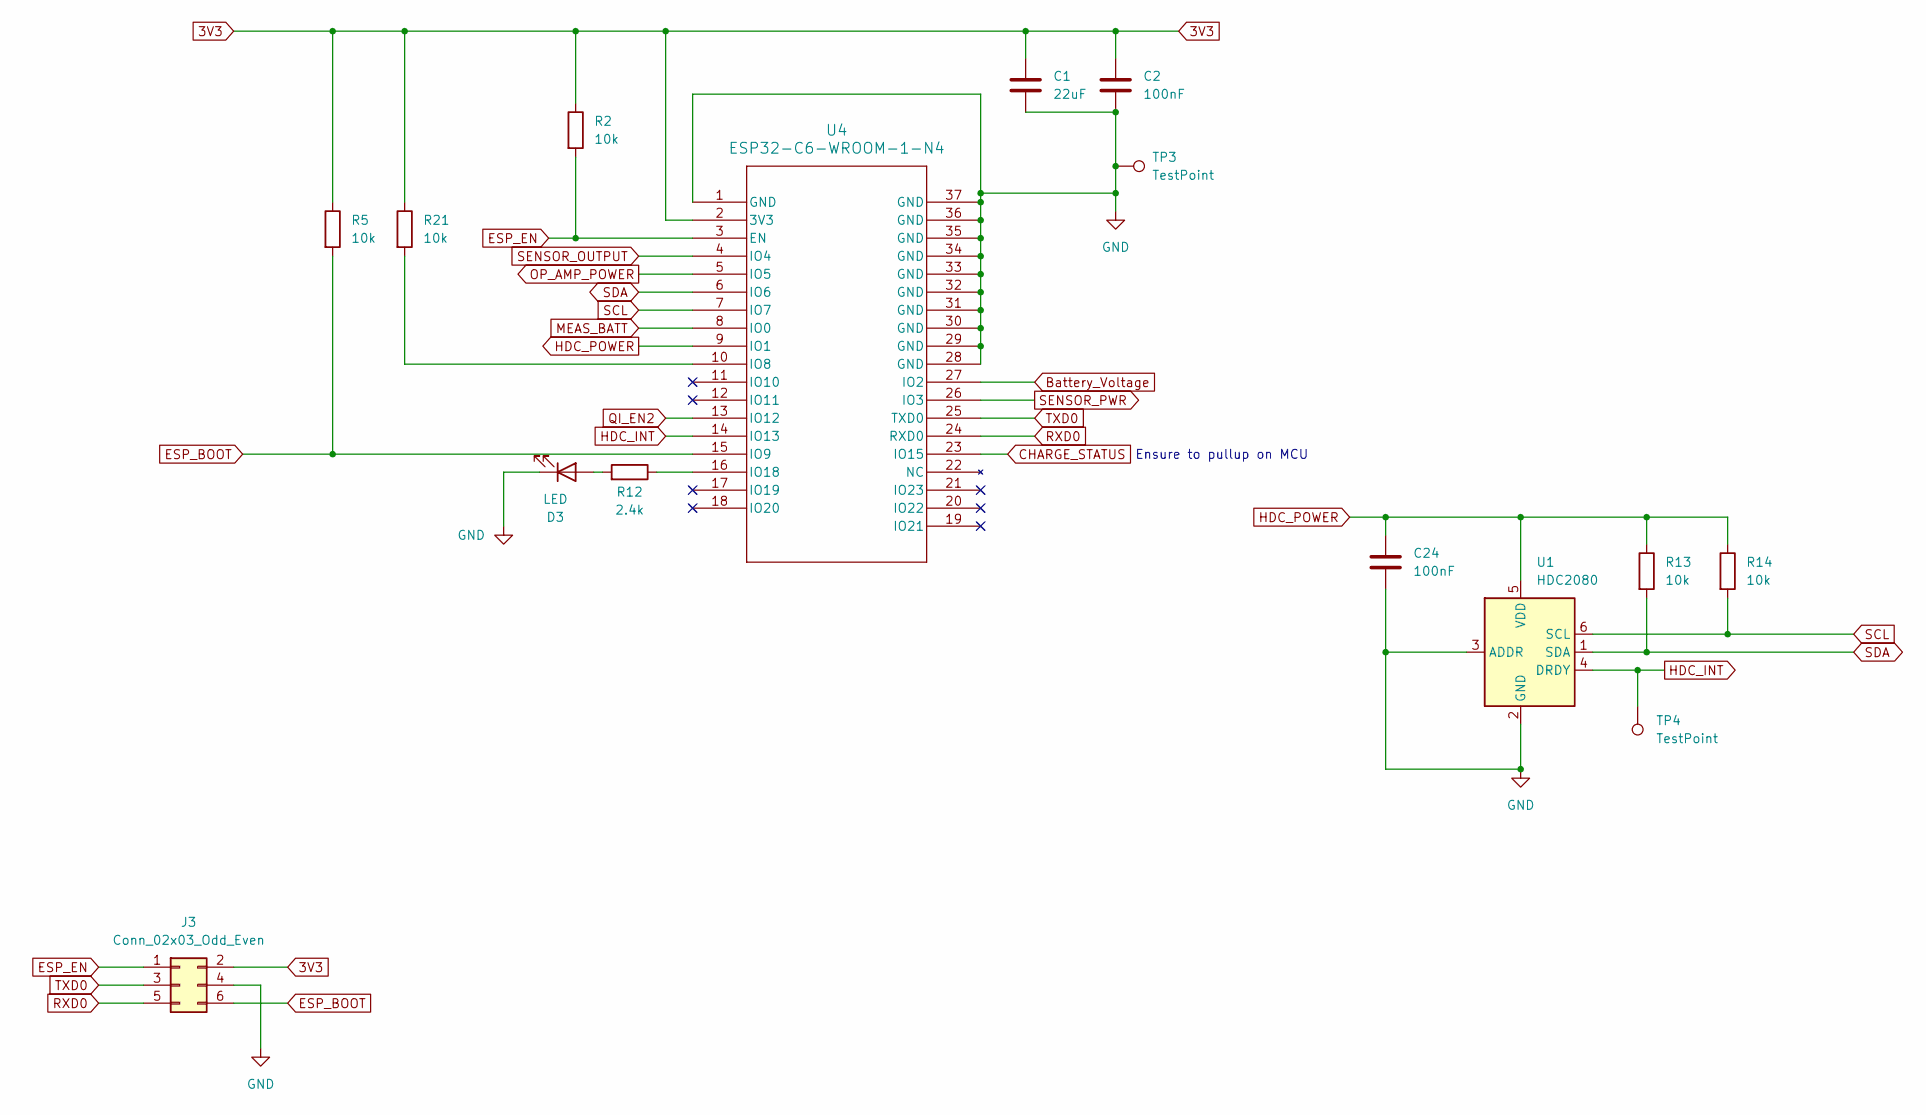
[picture p41: schematic MCU.kicad_sch, WashingLineMonitor-P0001]

Parts:
C1: 22uF; C_0805_2012Metric_Pad1.18x1.45mm_HandSolder
C2, C24: 100nF; C_0805_2012Metric_Pad1.18x1.45mm_HandSolder
D3: LED; LED_0805_2012Metric_Pad1.15x1.40mm_HandSolder
J3: Conn_02x03_Odd_Even; PinHeader_2x03_P1.27mm_Vertical_SMD; Digikey_Part_Number SAM13920TR-ND
R2, R5, R13, R14, R21: 10k; R_0805_2012Metric_Pad1.20x1.40mm_HandSolder
R12: 2.4k; R_0805_2012Metric_Pad1.20x1.40mm_HandSolder
TP3, TP4: TestPoint; TestPoint_Pad_D1.0mm
U1: HDC2080; Texas_S-PWSON-N6-HDC2080
U4: ESP32-C6-WROOM-1-N4; MOD28_ESP32-C6-WROOM-1_EXP

Connections:
3V3: C1.1, C2.1, J3.2, R2.1, R5.1, R21.1, U4.2 (3V3); also elsewhere on the board
Battery_Voltage: U4.27 (IO2); also elsewhere on the board
CHARGE_STATUS: U4.23 (IO15); also elsewhere on the board
ESP_BOOT: J3.6, R5.2, U4.15 (IO9)
ESP_EN: J3.1, R2.2, U4.3 (EN)
GND: C1.2, C2.2, C24.2, D3.1 (K), J3.4, TP3.1 (1_1), U1.2 (GND), U1.3 (ADDR), U4.1 (GND), U4.28 (GND), U4.29 (GND), U4.30 (GND), U4.31 (GND), U4.32 (GND), U4.33 (GND), U4.34 (GND), U4.35 (GND), U4.36 (GND), U4.37 (GND); also elsewhere on the board
HDC_INT: TP4.1 (1_1), U1.4 (DRDY), U4.14 (IO13)
HDC_POWER: C24.1, R13.1, R14.1, U1.5 (VDD), U4.9 (IO1)
MEAS_BATT: U4.8 (IO0); also elsewhere on the board
unnamed: D3.2 (A), R12.2
unnamed: R21.2, U4.10 (IO8)
unnamed: R12.1, U4.16 (IO18)
OP_AMP_POWER: U4.5 (IO5); also elsewhere on the board
QI_EN2: U4.13 (IO12); also elsewhere on the board
RXD0: J3.5, U4.24 (RXD0)
SCL: R14.2, U1.6 (SCL), U4.7 (IO7)
SDA: R13.2, U1.1 (SDA), U4.6 (IO6)
SENSOR_OUTPUT: U4.4 (IO4); also elsewhere on the board
SENSOR_PWR: U4.26 (IO3); also elsewhere on the board
TXD0: J3.3, U4.25 (TXD0)

Notes on the sheet:
Ensure to pullup on MCU

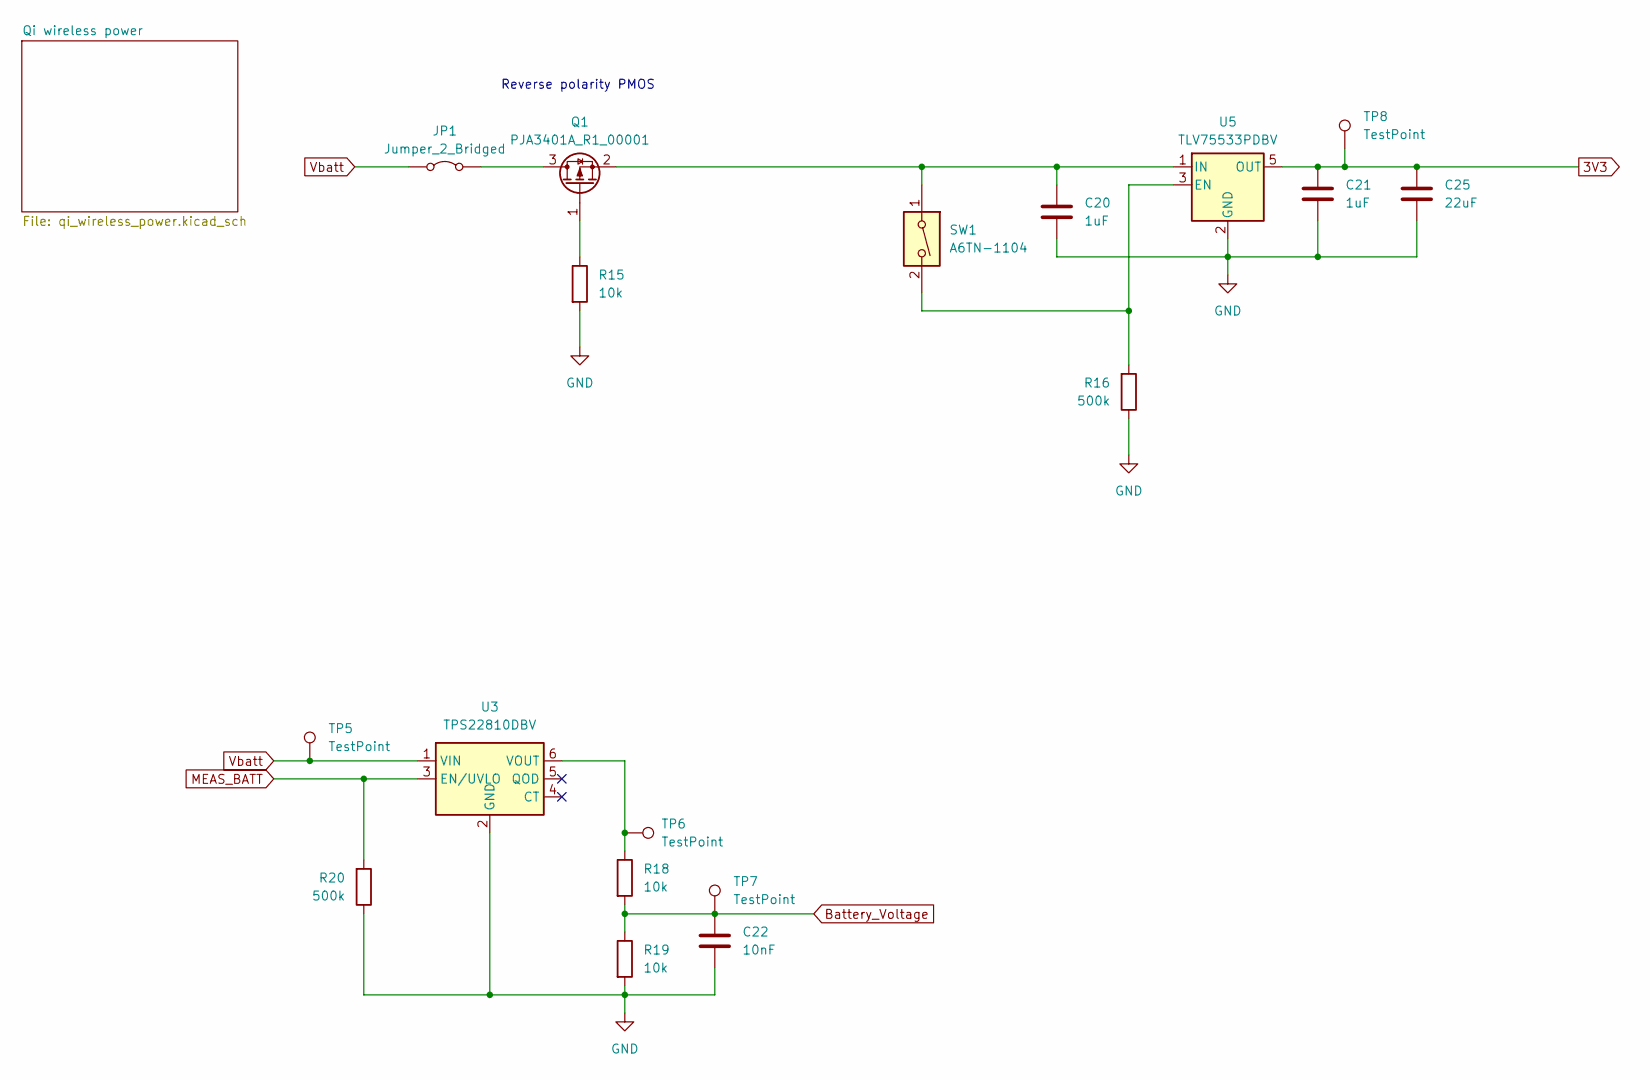
[picture p42: schematic INPUT_POWER.kicad_sch, WashingLineMonitor-P0001]

Parts:
C20, C21: 1uF; C_0805_2012Metric_Pad1.18x1.45mm_HandSolder
C22: 10nF; C_0805_2012Metric_Pad1.18x1.45mm_HandSolder
C25: 22uF; C_0805_2012Metric_Pad1.18x1.45mm_HandSolder
JP1: Jumper_2_Bridged; SolderJumper-2_P1.3mm_Bridged_RoundedPad1.0x1.5mm
Q1: PJA3401A_R1_00001; SOT-23
R15, R18, R19: 10k; R_0805_2012Metric_Pad1.20x1.40mm_HandSolder
R16, R20: 500k; R_0805_2012Metric_Pad1.20x1.40mm_HandSolder
SW1: A6TN-1104; SW_DIP_SPSTx01_Slide_6.7x4.1mm_W7.62mm_P2.54mm_LowProfile
TP5, TP6, TP7, TP8: TestPoint; TestPoint_Pad_D1.0mm
U3: TPS22810DBV; SOT-23-6
U5: TLV75533PDBV; SOT-23-5

Connections:
3V3: C21.2, C25.1, TP8.1 (1_1), U5.5 (OUT); also elsewhere on the board
Battery_Voltage: C22.1, R18.2, R19.1, TP7.1 (1_1); also elsewhere on the board
GND: C20.1, C21.1, C22.2, C25.2, R15.2, R16.1, R19.2, R20.1, U3.2 (GND), U5.2 (GND); also elsewhere on the board
MEAS_BATT: R20.2, U3.3 (EN/UVLO); also elsewhere on the board
unnamed: JP1.2 (B), Q1.3 (D)
unnamed: Q1.1 (G), R15.1
unnamed: C20.2, Q1.2 (S), SW1.1, U5.1 (IN)
unnamed: R18.1, TP6.1 (1_1), U3.6 (VOUT)
unnamed: R16.2, SW1.2, U5.3 (EN)
Vbatt: JP1.1 (A), TP5.1 (1_1), U3.1 (VIN); also elsewhere on the board

Notes on the sheet:
Reverse polarity PMOS

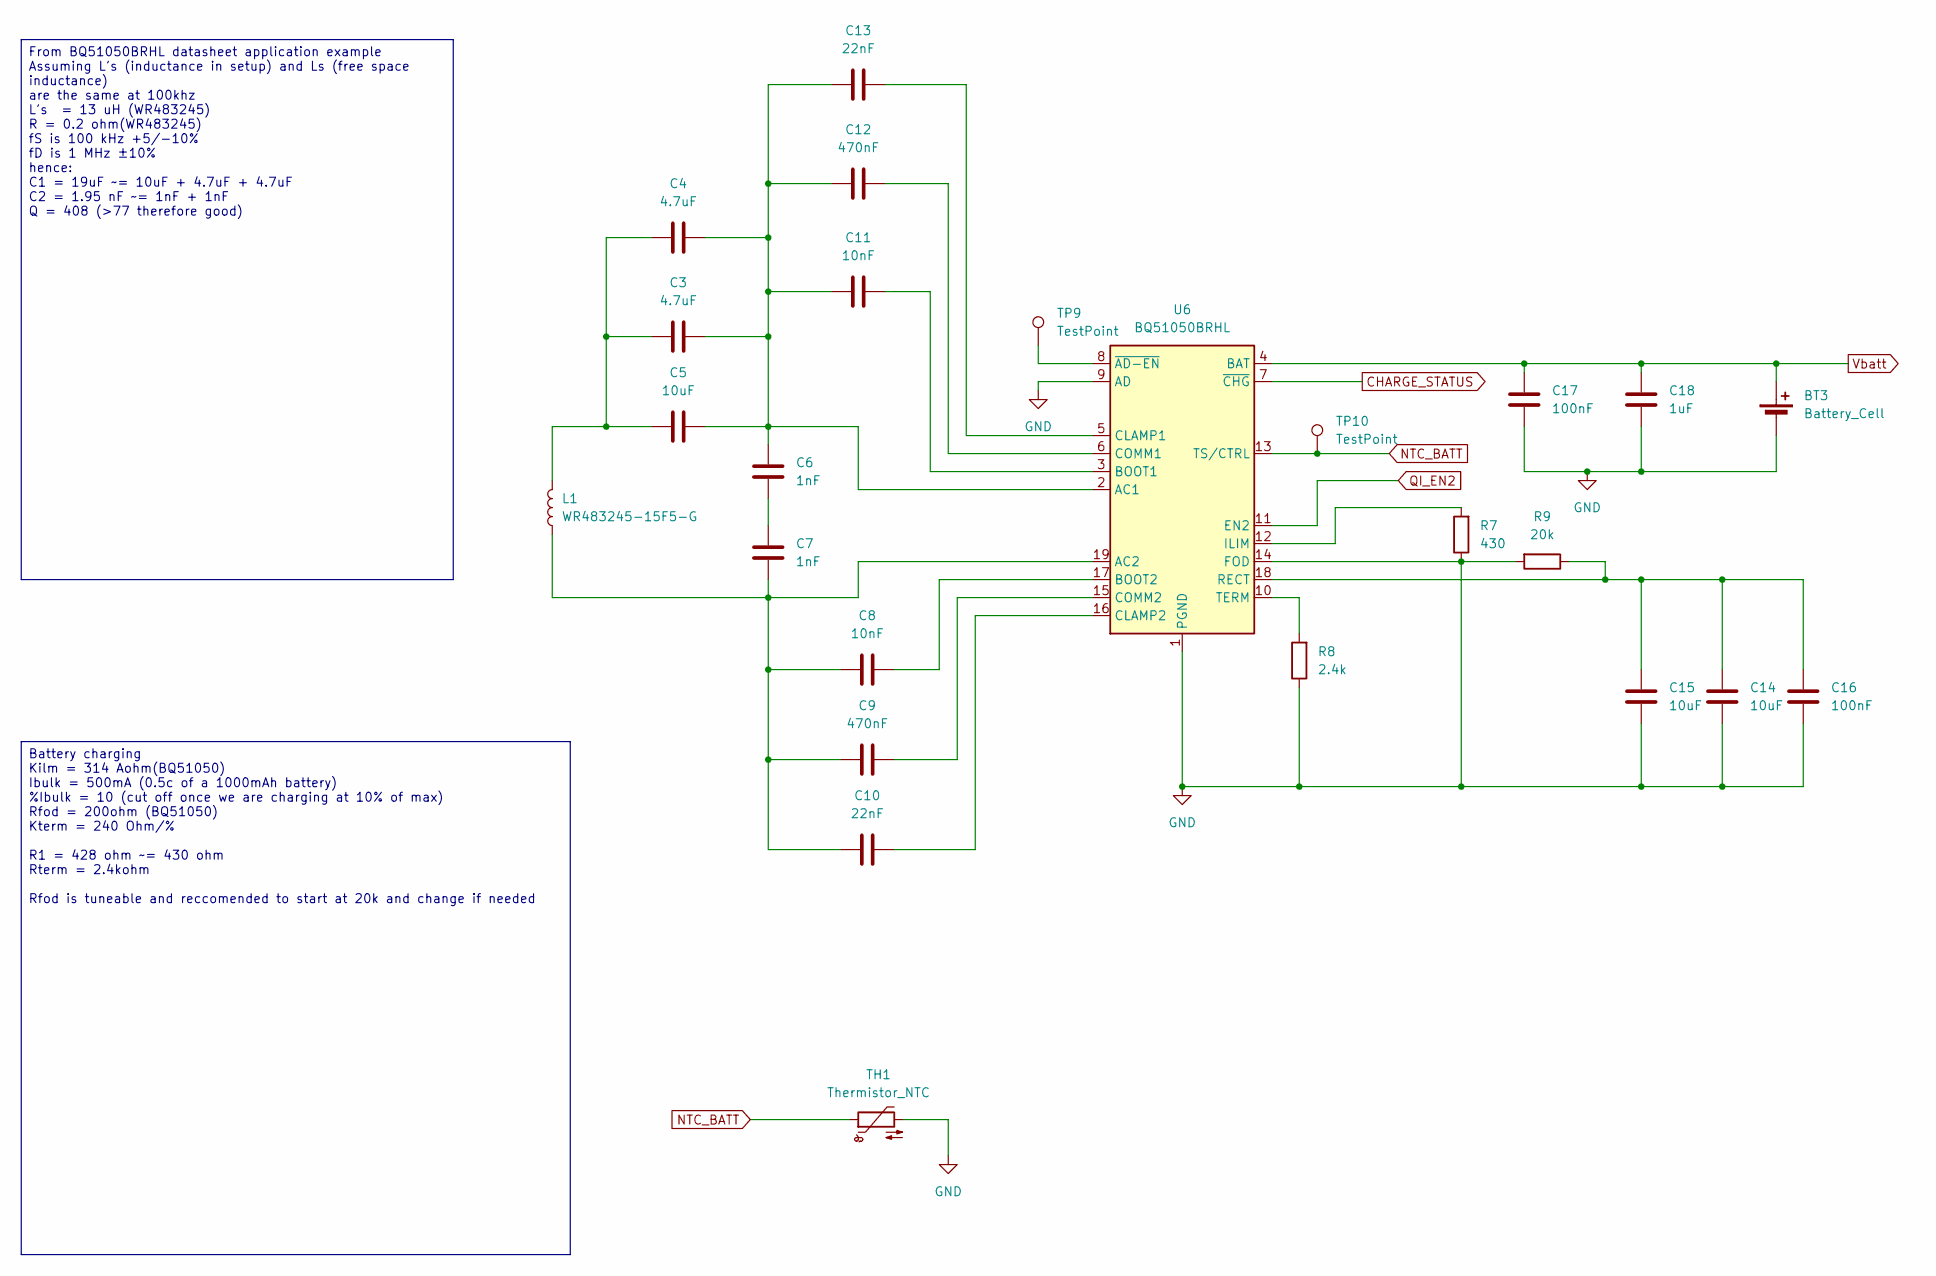
[picture p43: schematic qi_wireless_power.kicad_sch, WashingLineMonitor-P0001]

Parts:
BT3: Battery_Cell; JST_SH_SM02B-SRSS-TB_1x02-1MP_P1.00mm_Horizontal
C3, C4: 4.7uF; C_0805_2012Metric_Pad1.18x1.45mm_HandSolder
C5, C14, C15: 10uF; C_0805_2012Metric_Pad1.18x1.45mm_HandSolder
C6, C7: 1nF; C_0805_2012Metric_Pad1.18x1.45mm_HandSolder
C8, C11: 10nF; C_0805_2012Metric_Pad1.18x1.45mm_HandSolder
C9, C12: 470nF; C_0805_2012Metric_Pad1.18x1.45mm_HandSolder
C10, C13: 22nF; C_0805_2012Metric_Pad1.18x1.45mm_HandSolder
C16, C17: 100nF; C_0805_2012Metric_Pad1.18x1.45mm_HandSolder
C18: 1uF; C_0805_2012Metric_Pad1.18x1.45mm_HandSolder
L1: WR483245-15F5-G; JST_SH_SM02B-SRSS-TB_1x02-1MP_P1.00mm_Horizontal; JLC_Part_Number C5331042
R7: 430; R_0805_2012Metric_Pad1.20x1.40mm_HandSolder
R8: 2.4k; R_0805_2012Metric_Pad1.20x1.40mm_HandSolder
R9: 20k; R_0805_2012Metric_Pad1.20x1.40mm_HandSolder
TH1: Thermistor_NTC; R_0402_1005Metric_Pad0.72x0.64mm_HandSolder
TP9, TP10: TestPoint; TestPoint_Pad_D1.0mm
U6: BQ51050BRHL; Texas_VQFN-RHL-20; JLC_Part_Number C2650144

Connections:
CHARGE_STATUS: U6.7 (~CHG); also elsewhere on the board
GND: BT3.2 (-), C14.1, C15.1, C16.1, C17.1, C18.1, R7.1, R8.1, R9.2, TH1.2, U6.1 (PGND), U6.9 (AD), U6.14 (FOD), U6.20 (PGND), U6.21 (PGND); also elsewhere on the board
NTC_BATT: TH1.1, TP10.1 (1_1), U6.13 (TS/CTRL)
unnamed: C3.1, C4.1, C5.1, L1.2
unnamed: C6.1, C7.2
unnamed: C3.2, C4.2, C5.2, C6.2, C11.2, C12.2, C13.2, U6.2 (AC1)
unnamed: C7.1, C8.2, C9.2, C10.2, L1.1, U6.19 (AC2)
unnamed: C11.1, U6.3 (BOOT1)
unnamed: C8.1, U6.17 (BOOT2)
unnamed: C13.1, U6.5 (CLAMP1)
unnamed: C10.1, U6.16 (CLAMP2)
unnamed: C12.1, U6.6 (COMM1)
unnamed: C9.1, U6.15 (COMM2)
unnamed: R7.2, U6.12 (ILIM)
unnamed: C14.2, C15.2, C16.2, R9.1, U6.18 (RECT)
unnamed: R8.2, U6.10 (TERM)
unnamed: TP9.1 (1_1), U6.8 (~AD-EN)
QI_EN2: U6.11 (EN2); also elsewhere on the board
Vbatt: BT3.1 (+), C17.2, C18.2, U6.4 (BAT); also elsewhere on the board

Notes on the sheet:
Battery charging Kilm = 314 Aohm(BQ51050) Ibulk = 500mA (0.5c of a 1000mAh battery) %Ibulk = 10 (cut off once we are charging at 10% of max) Rfod = 200ohm (BQ51050) Kterm = 240 Ohm/% R1 = 428 ohm ~= 430 ohm Rterm = 2.4kohm Rfod is tuneable and reccomended to start at 20k and change if needed
From BQ51050BRHL datasheet application example Assuming L's (inductance in setup) and Ls (free space inductance) are the same at 100khz L's = 13 uH (WR483245) R = 0.2 ohm(WR483245) fS is 100 kHz +5/-10% fD is 1 MHz ±10% hence: C1 = 19uF ~= 10uF + 4.7uF + 4.7uF C2 = 1.95 nF ~= 1nF + 1nF Q = 408 (>77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

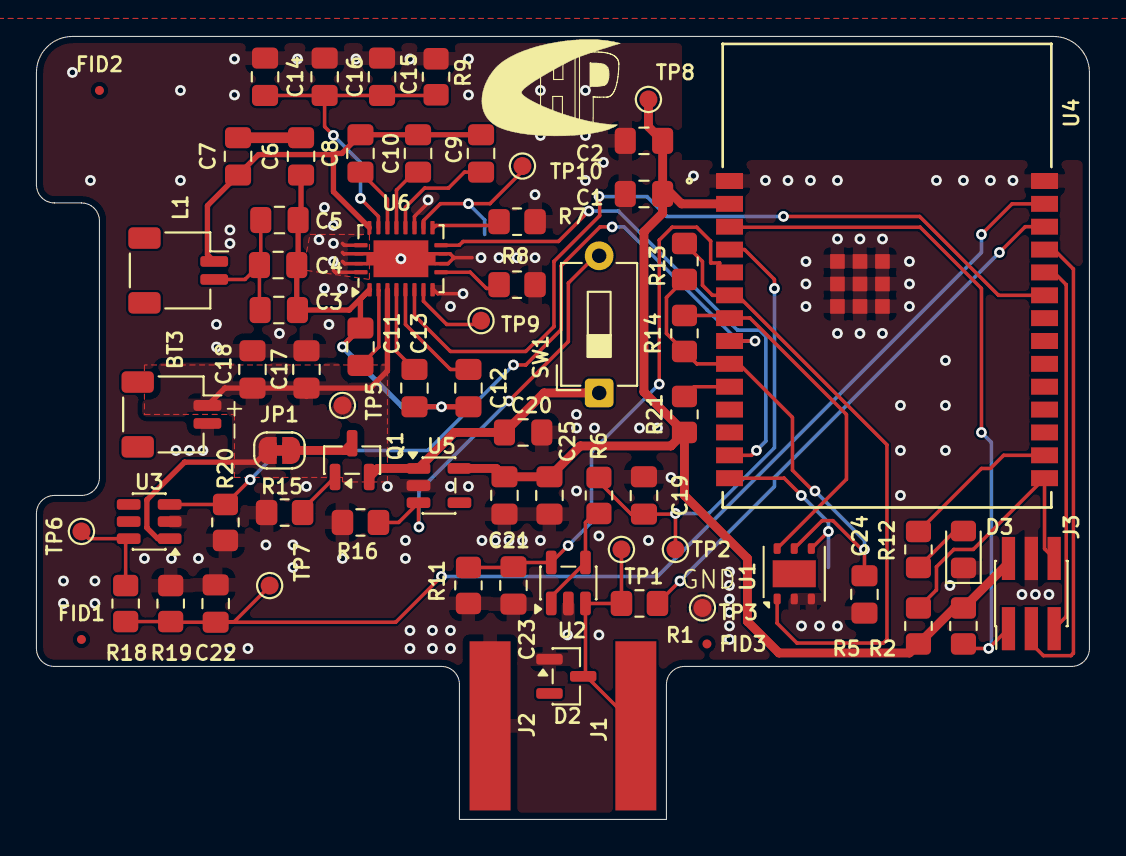
[picture p44: board WashingLineMonitor-P0001.kicad_pcb from above]

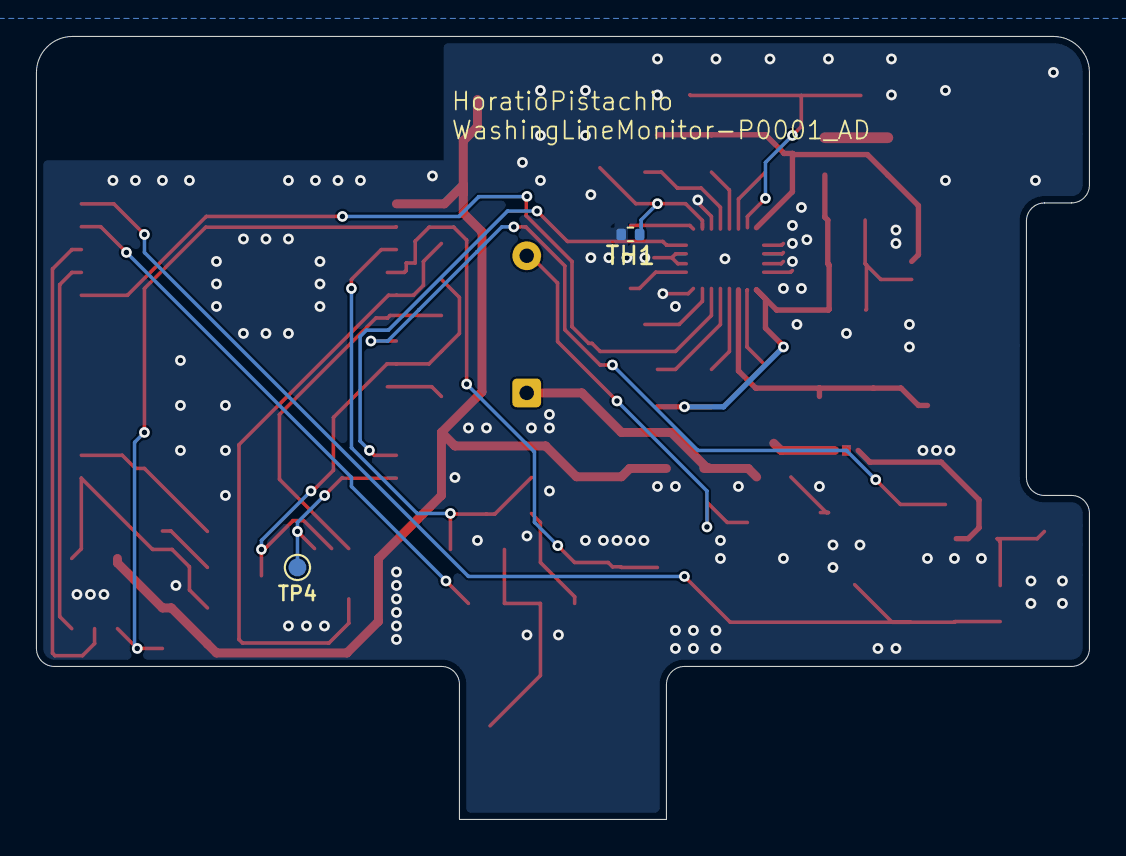
[picture p45: board WashingLineMonitor-P0001.kicad_pcb from below]

Board: 2 copper layers, 58.5 x 43.5 mm, 72 parts (2 on the bottom side), 43 nets.
