horatioPistachio/WashingLineMonitor-P0001/(commit log)

2025-08-17 Added QI wireless charging circuit
    [INPUT_POWER.kicad_sch, MCU.kicad_sch, Moisture_sensor.kicad_sch, Primary_battery_concept.kicad_sch, WashingLineMonitor-P0001.kicad_sch, qi_wireless_charging.kicad_sch]
2025-08-17 Added esp32-s2-solo module
2025-09-13 Completed first iteration and reviews
    [INPUT_POWER.kicad_sch, Li-ion_BMS.kicad_sch, MCU.kicad_sch, Moisture_sensor.kicad_sch, WashingLineMonitor-P0001.kicad_pcb, WashingLineMonitor-P0001.kicad_sch, WashingLineMonitor-P0001.step, qi_wireless_power.kicad_sch]
2025-09-14 added exports
    [WashingLineMonitor-P0001-B_Cu.gbl, WashingLineMonitor-P0001-B_Mask.gbs, WashingLineMonitor-P0001-B_Paste.gbp, WashingLineMonitor-P0001-B_Silkscreen.gbo, WashingLineMonitor-P0001-Edge_Cuts.gm1, WashingLineMonitor-P0001-F_Cu.gtl, WashingLineMonitor-P0001-F_Mask.gts, WashingLineMonitor-P0001-F_Paste.gtp]
2025-09-14 Update KiCad PPA to use releases version
2026-05-11 commit of local files before designing next version
    [INPUT_POWER.kicad_sch, MCU.kicad_sch, Moisture_sensor.kicad_sch, WashingLineMonitor-P0001.kicad_pcb, WashingLineMonitor-P0001.kicad_sch, qi_wireless_power.kicad_sch]
2026-05-30 updated schematic from review
    [INPUT_POWER.kicad_sch, MCU.kicad_sch, Moisture_sensor.kicad_sch, WashingLineMonitor-P0001.kicad_sch, qi_wireless_power.kicad_sch]
2026-05-30 laid out pcb
    [INPUT_POWER.kicad_sch, MCU.kicad_sch, Moisture_sensor.kicad_sch, WashingLineMonitor-P0001.kicad_pcb, qi_wireless_power.kicad_sch]
2026-06-04 Near complete AC
    [INPUT_POWER.kicad_sch, MCU.kicad_sch, Moisture_sensor.kicad_sch, WashingLineMonitor-P0001.kicad_pcb, qi_wireless_power.kicad_sch]
2026-06-06 Minor pre release changes
    [INPUT_POWER.kicad_sch, MCU.kicad_sch, Moisture_sensor.kicad_sch, WashingLineMonitor-P0001.kicad_pcb, WashingLineMonitor-P0001.kicad_sch, qi_wireless_power.kicad_sch]
2026-07-13 Added boot pin strapping
    [MCU.kicad_sch, WashingLineMonitor-P0001.kicad_pcb, WashingLineMonitor-P0001.kicad_sch]
2026-07-25 finished board layout for AD revision
    [INPUT_POWER.kicad_sch, MCU.kicad_sch, WashingLineMonitor-P0001.kicad_pcb, WashingLineMonitor-P0001.kicad_sch]
2026-07-25 Added AC and AD export artifects
    [WashingLineMonitor-P0001-B_Cu.gbl, WashingLineMonitor-P0001-B_Mask.gbs, WashingLineMonitor-P0001-B_Paste.gbp, WashingLineMonitor-P0001-B_Silkscreen.gbo, WashingLineMonitor-P0001-Edge_Cuts.gm1, WashingLineMonitor-P0001-F_Cu.gtl, WashingLineMonitor-P0001-F_Mask.gts, WashingLineMonitor-P0001-F_Paste.gtp]
